Rithvik-Vadlamani/kvm-switch/verification-A2/additional-review/methods/README.md

These are the actual verification methods. Paths refer to the recorded workspace layout and must be adjusted for independent reproduction. Use the matching A2 routing geometry, netlists, firmware and Gerbers supplied in the release folders. KiCad 10 Python/CLI, C compiler, Python numpy/scipy/shapely, Gerbonara and Node sharp are required as applicable. The firmware oracle compiles actual control.c. AUDIT_LABEL=A2 selects original Gerbers for raster extraction; default selects economy. The optional bridge/missing_drill modes inject deliberate faults and are expected to report INVESTIGATE. Historical field/thermal models remain in Economy-additional-review and have not been promoted to hardware validation.
