Rithvik-Vadlamani/kvm-switch/verification-A2/additional-review/Deferred-tests.md

No physical test is marked passed. Check rail/reset waveforms for slow rise, abrupt dropout, brownout, external reset and watchdog reset; HDMI/host partially powered conditions; 4-port capacitor inrush and full-load/short-circuit recovery; USB hot-plug and both USB-C orientations; two actual monitors at 1440p60 + 1080p60; DDC/HPD/EDID; thermal rise at stepped loads and intended ambient/enclosure; exposed-pad solder joints, HDMI shield-tail proximity to R30/U20, and connector strength. Factory DFM/stackup acceptance, delivered pricing and complete channel/EMI/ESD compliance remain unverified. Start physical characterization with a current-limited supply and measure before claiming full-load operation.
