Rithvik-Vadlamani/kvm-switch/verification-A2/additional-review/Factory-status.md

No JLCDFM result or human factory approval has been obtained for A2. A separate sign-in was requested in the earlier review; the final browser check returned no active review page/report. Matching final Gerbers are supplied for submission when a signed-in session is available. No supplier message, order or payment was sent. Existing quote/cart state has not been reconciled with the new A2 parts.
