Rithvik-Vadlamani/kvm-switch/(list of files, drawings)

Other design files:
verification-A2/PCB-DRC.json
