Rithvik-Vadlamani/kvm-switch/KVM_Switch.kicad_pcb

## KiCad design KVM_Switch.kicad_pcb (2026-10-14)

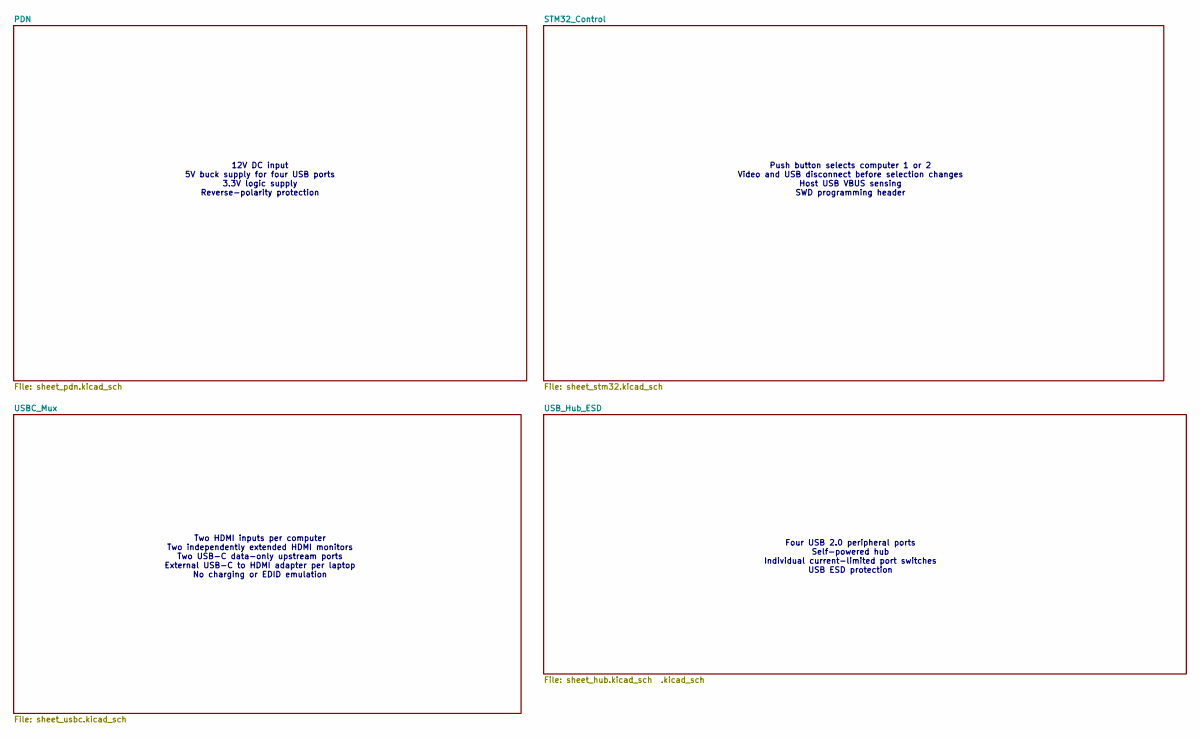
[picture p1: schematic KVM_Switch.kicad_sch, Two-computer HDMI and USB switch]

Notes on the sheet:
Four USB 2.0 peripheral ports Self-powered hub Individual current-limited port switches USB ESD protection
Two HDMI inputs per computer Two independently extended HDMI monitors Two USB-C data-only upstream ports External USB-C to HDMI adapter per laptop No charging or EDID emulation
Push button selects computer 1 or 2 Video and USB disconnect before selection changes Host USB VBUS sensing SWD programming header
12V DC input 5V buck supply for four USB ports 3.3V logic supply Reverse-polarity protection

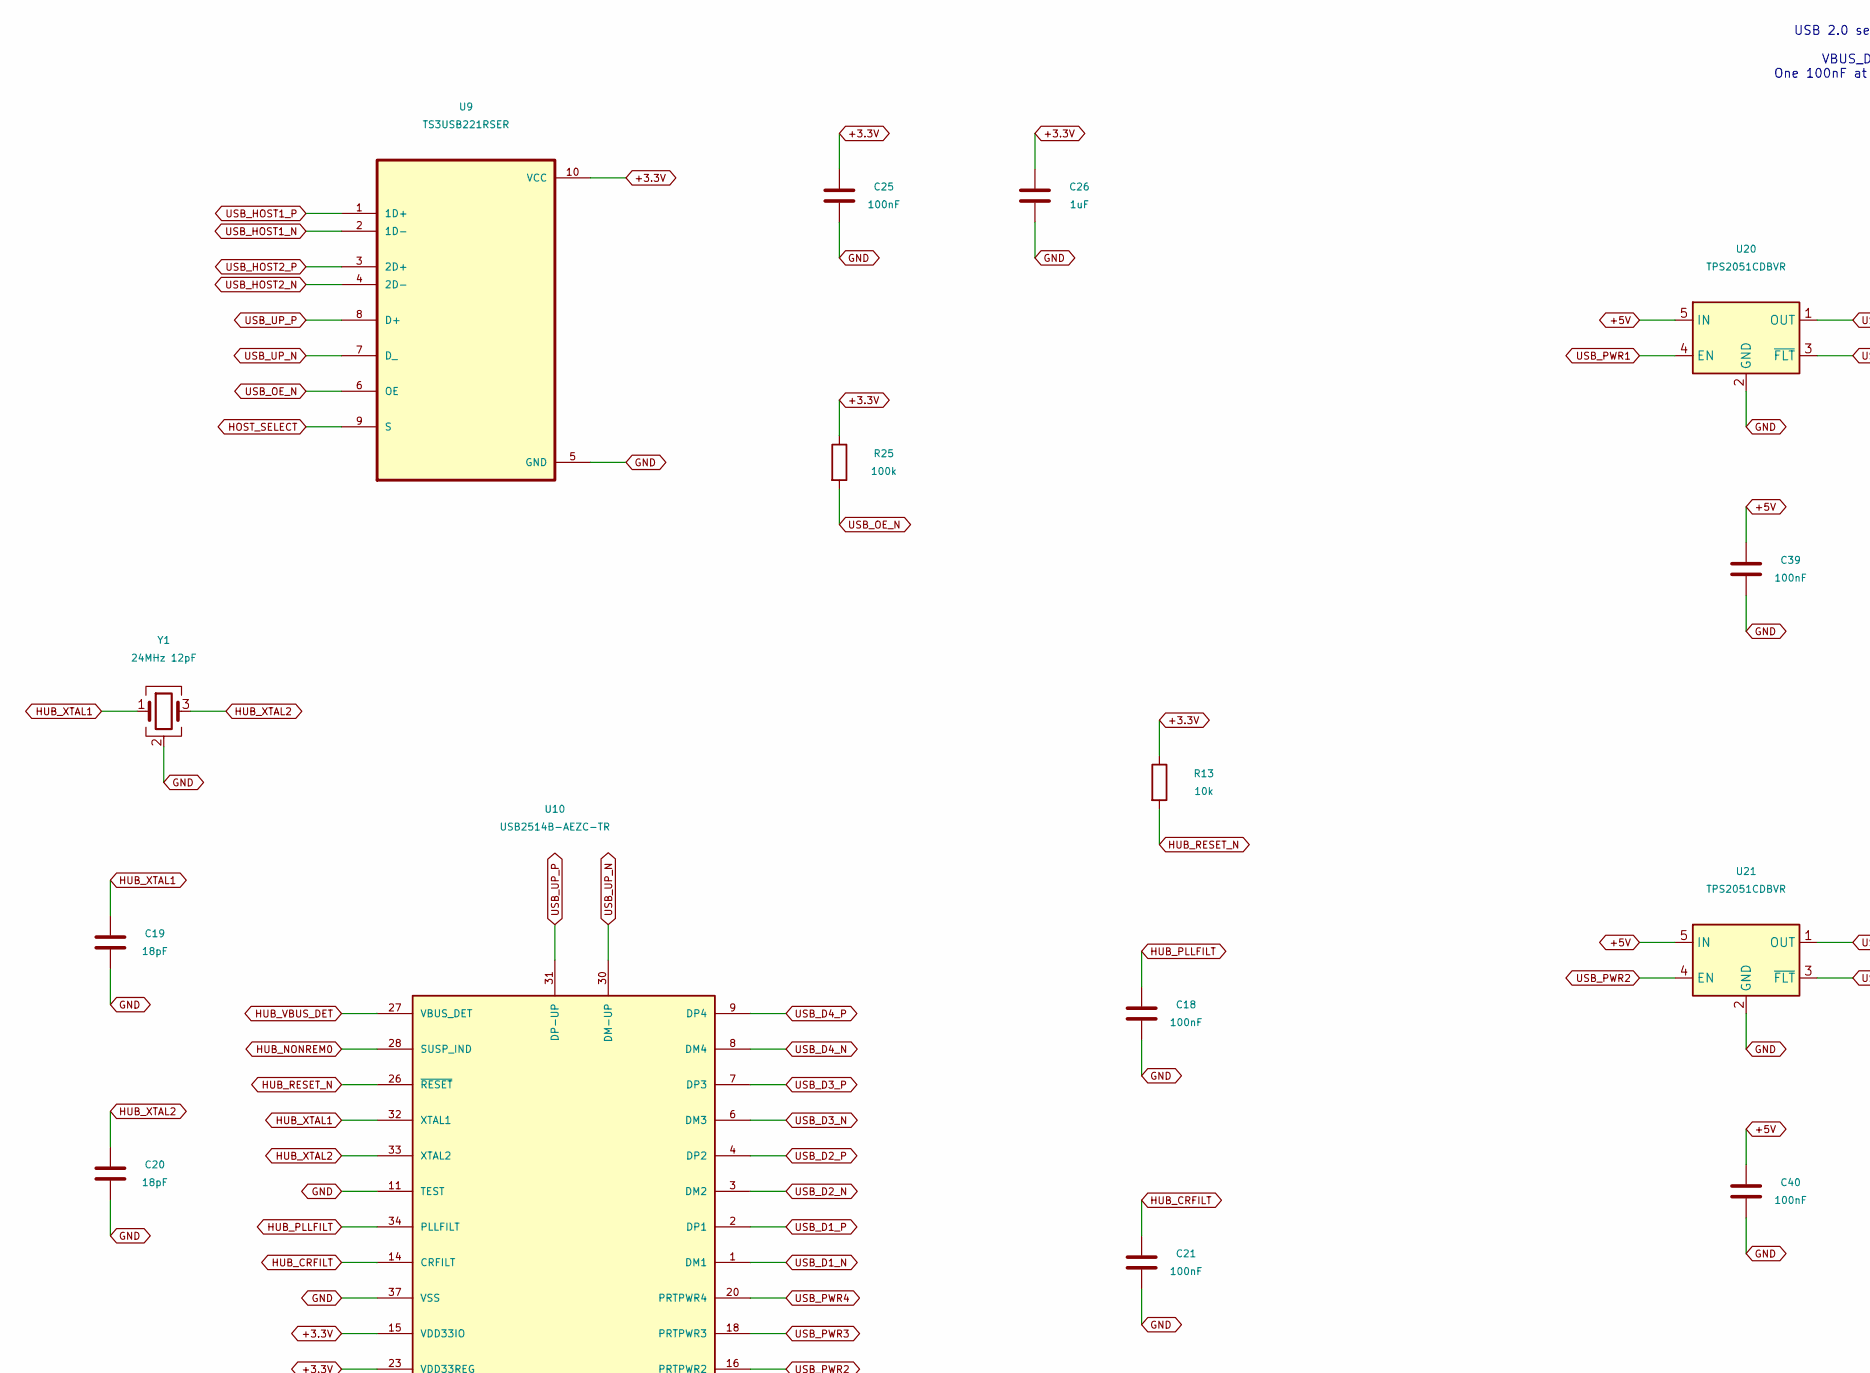
[picture p2: schematic sheet_hub.kicad_sch .kicad_sch, Two-computer HDMI and USB switch, part in row 1, column 1]

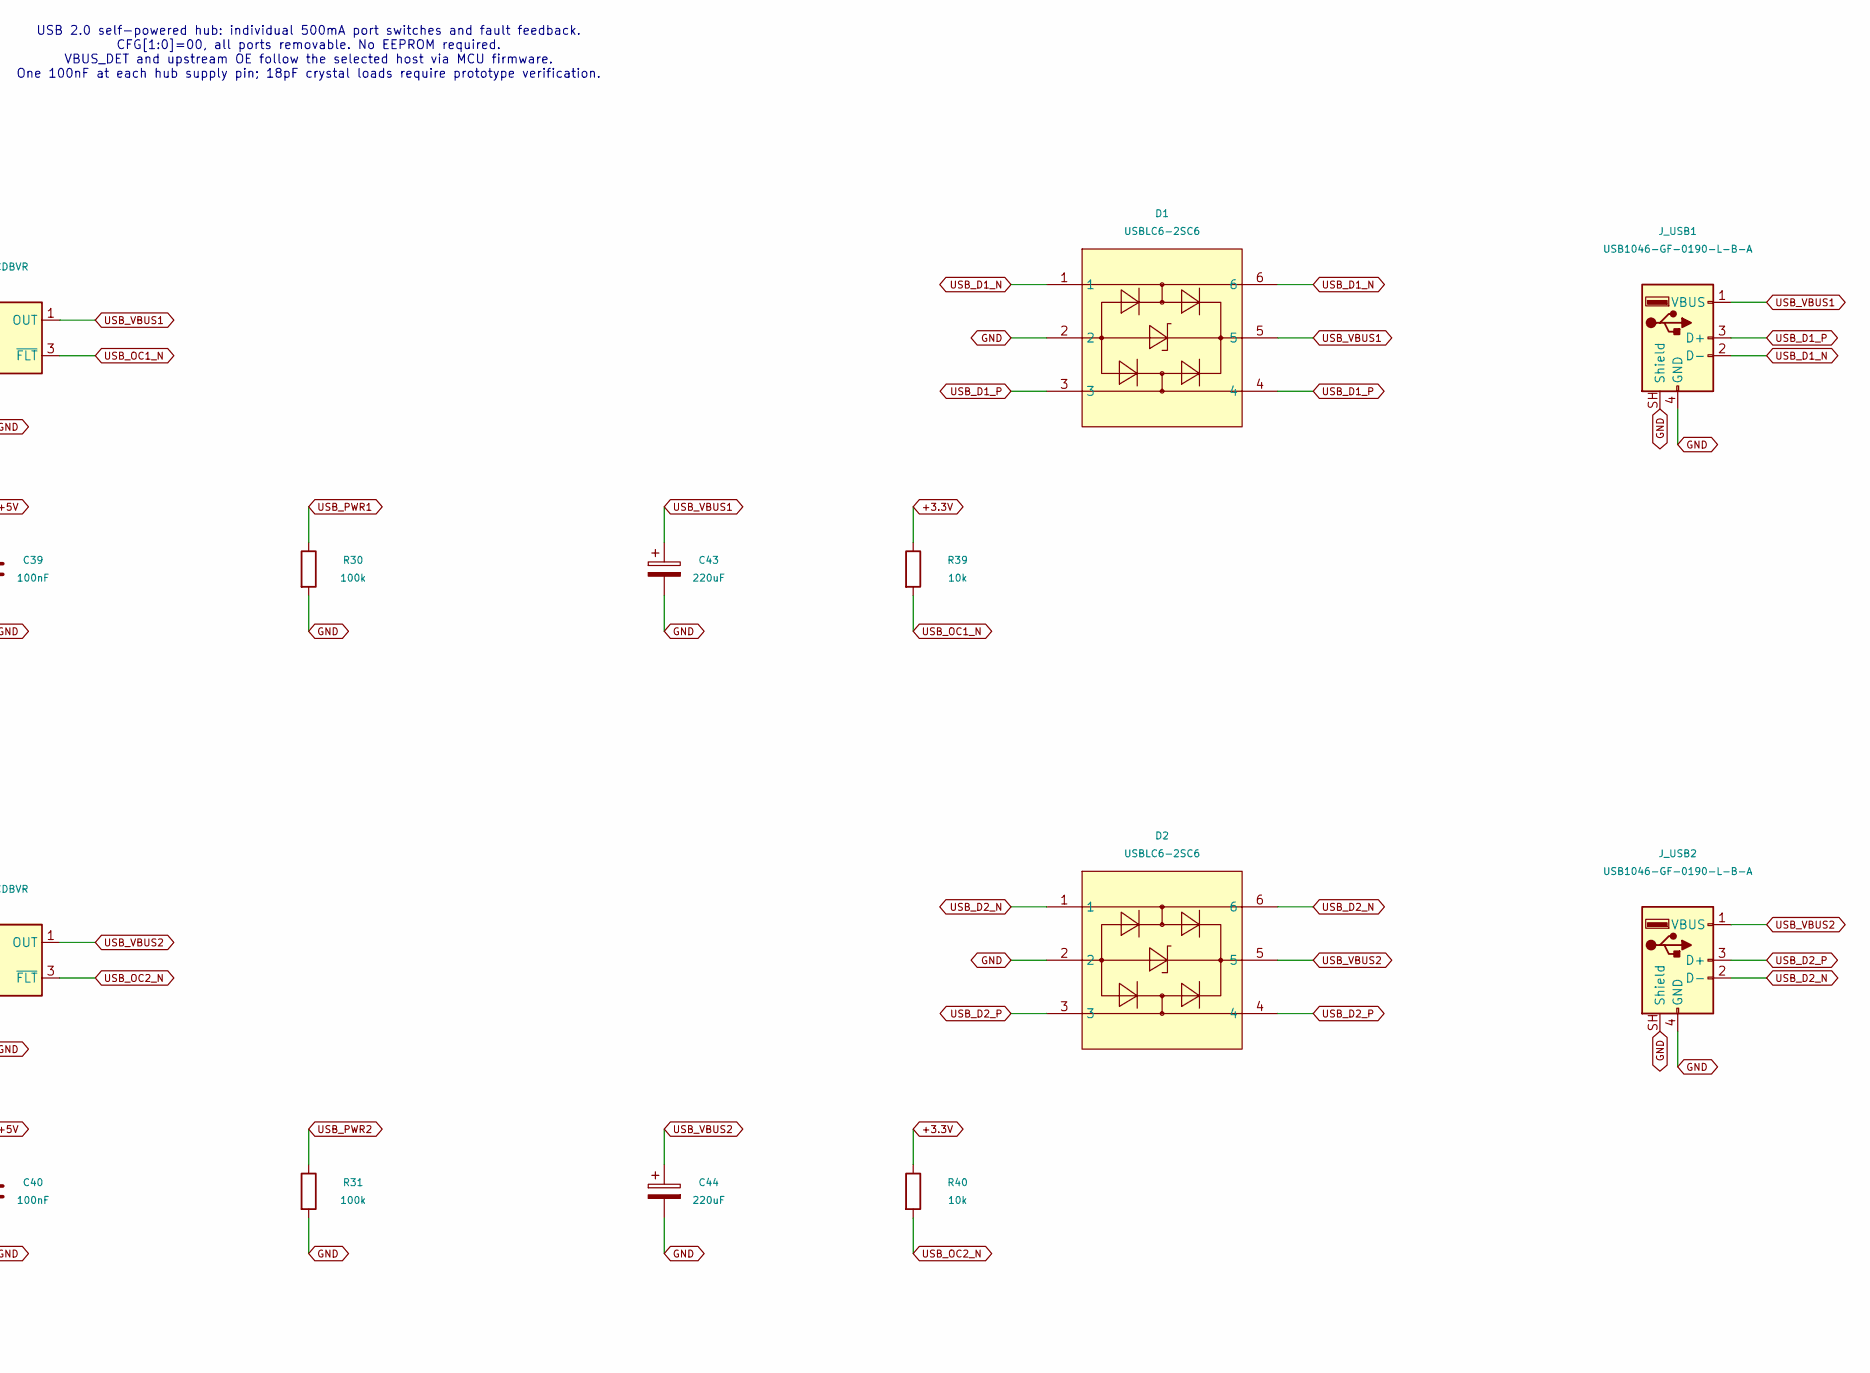
[picture p3: schematic sheet_hub.kicad_sch .kicad_sch, Two-computer HDMI and USB switch, part in row 1, column 2]

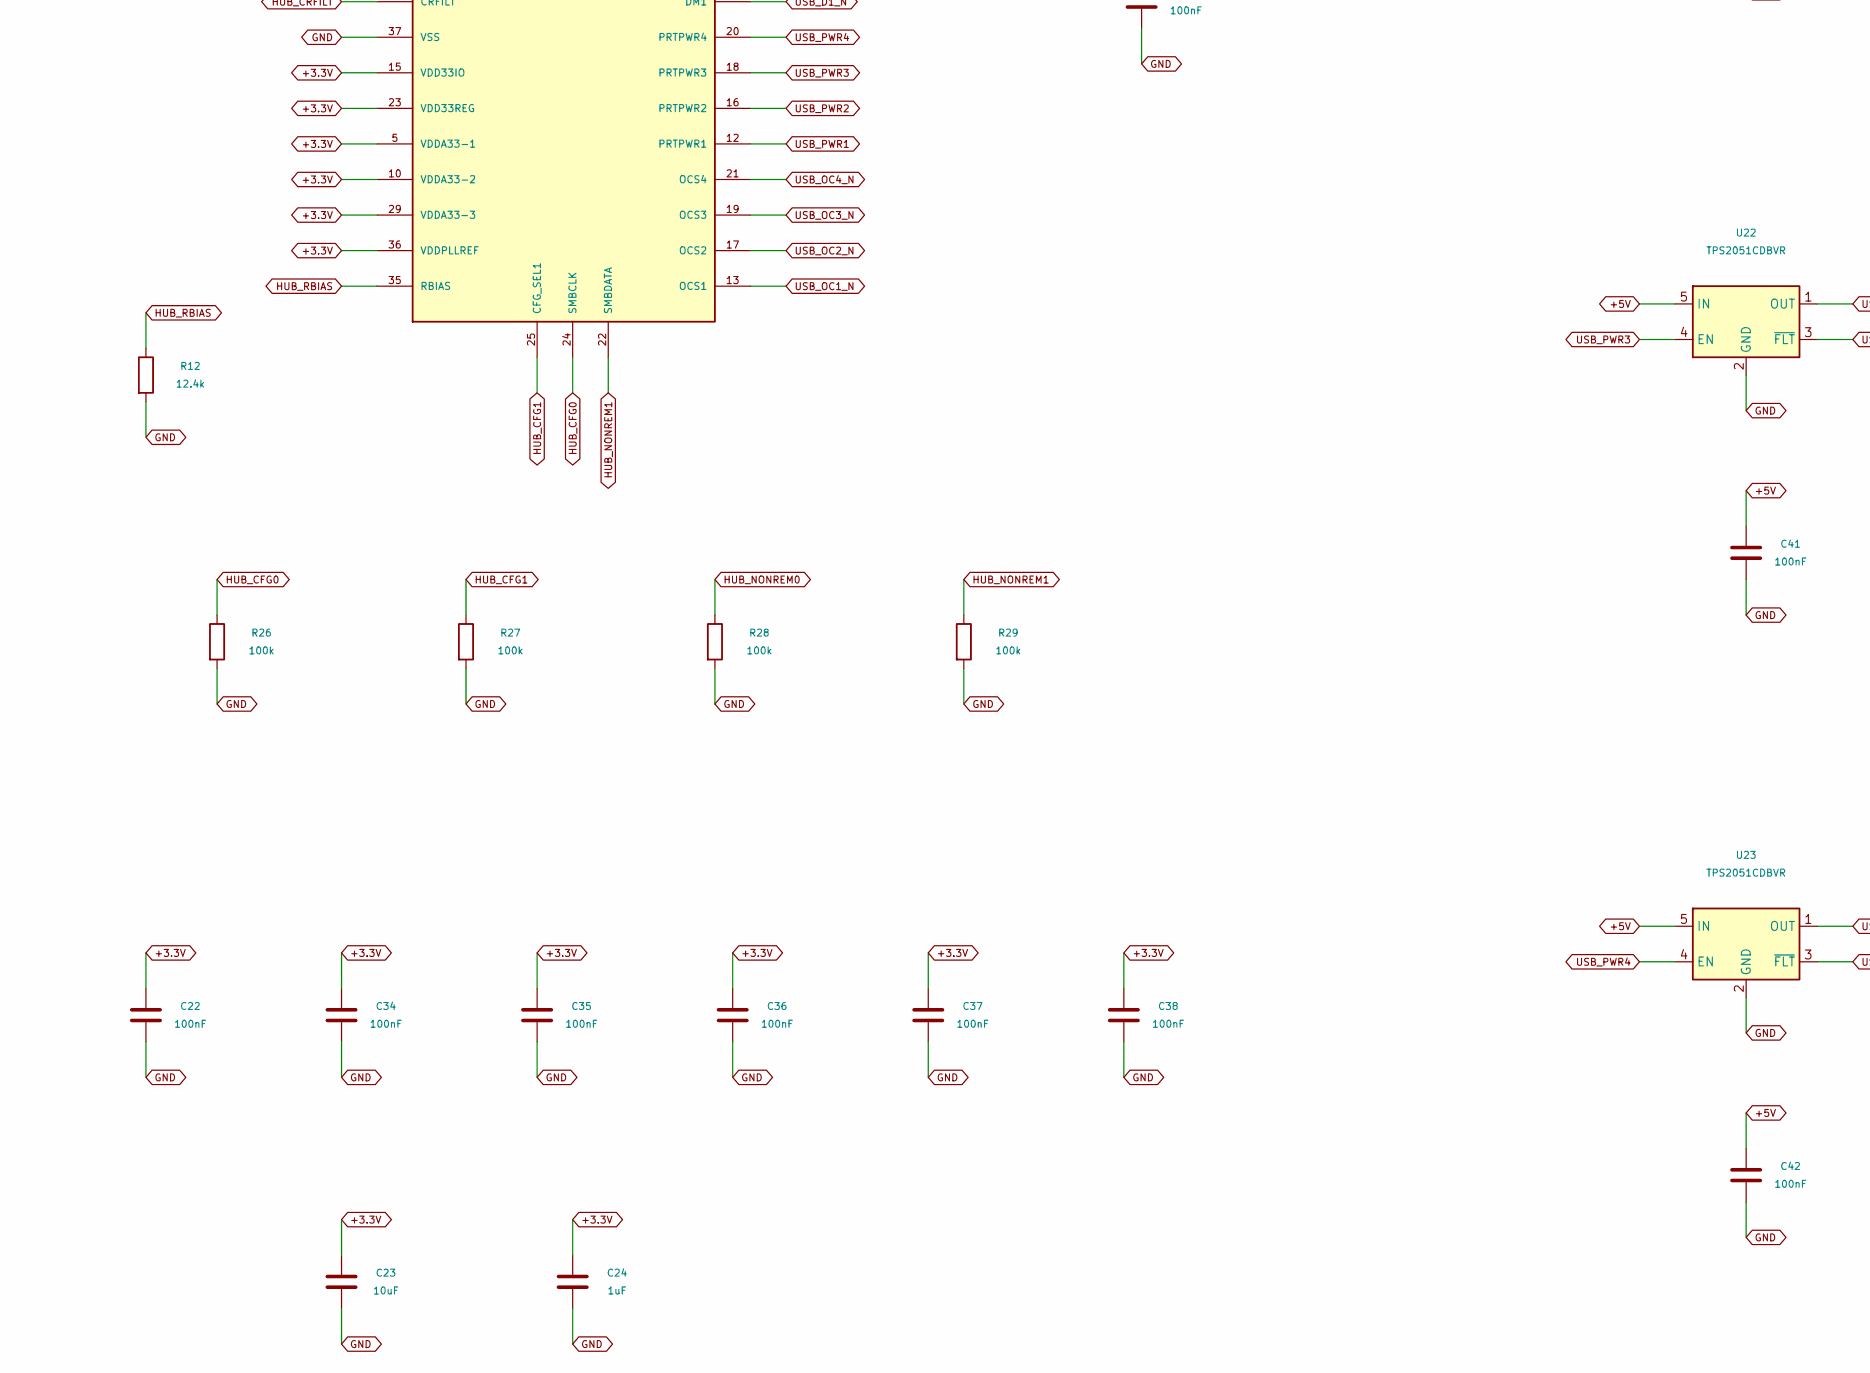
[picture p4: schematic sheet_hub.kicad_sch .kicad_sch, Two-computer HDMI and USB switch, part in row 2, column 1]

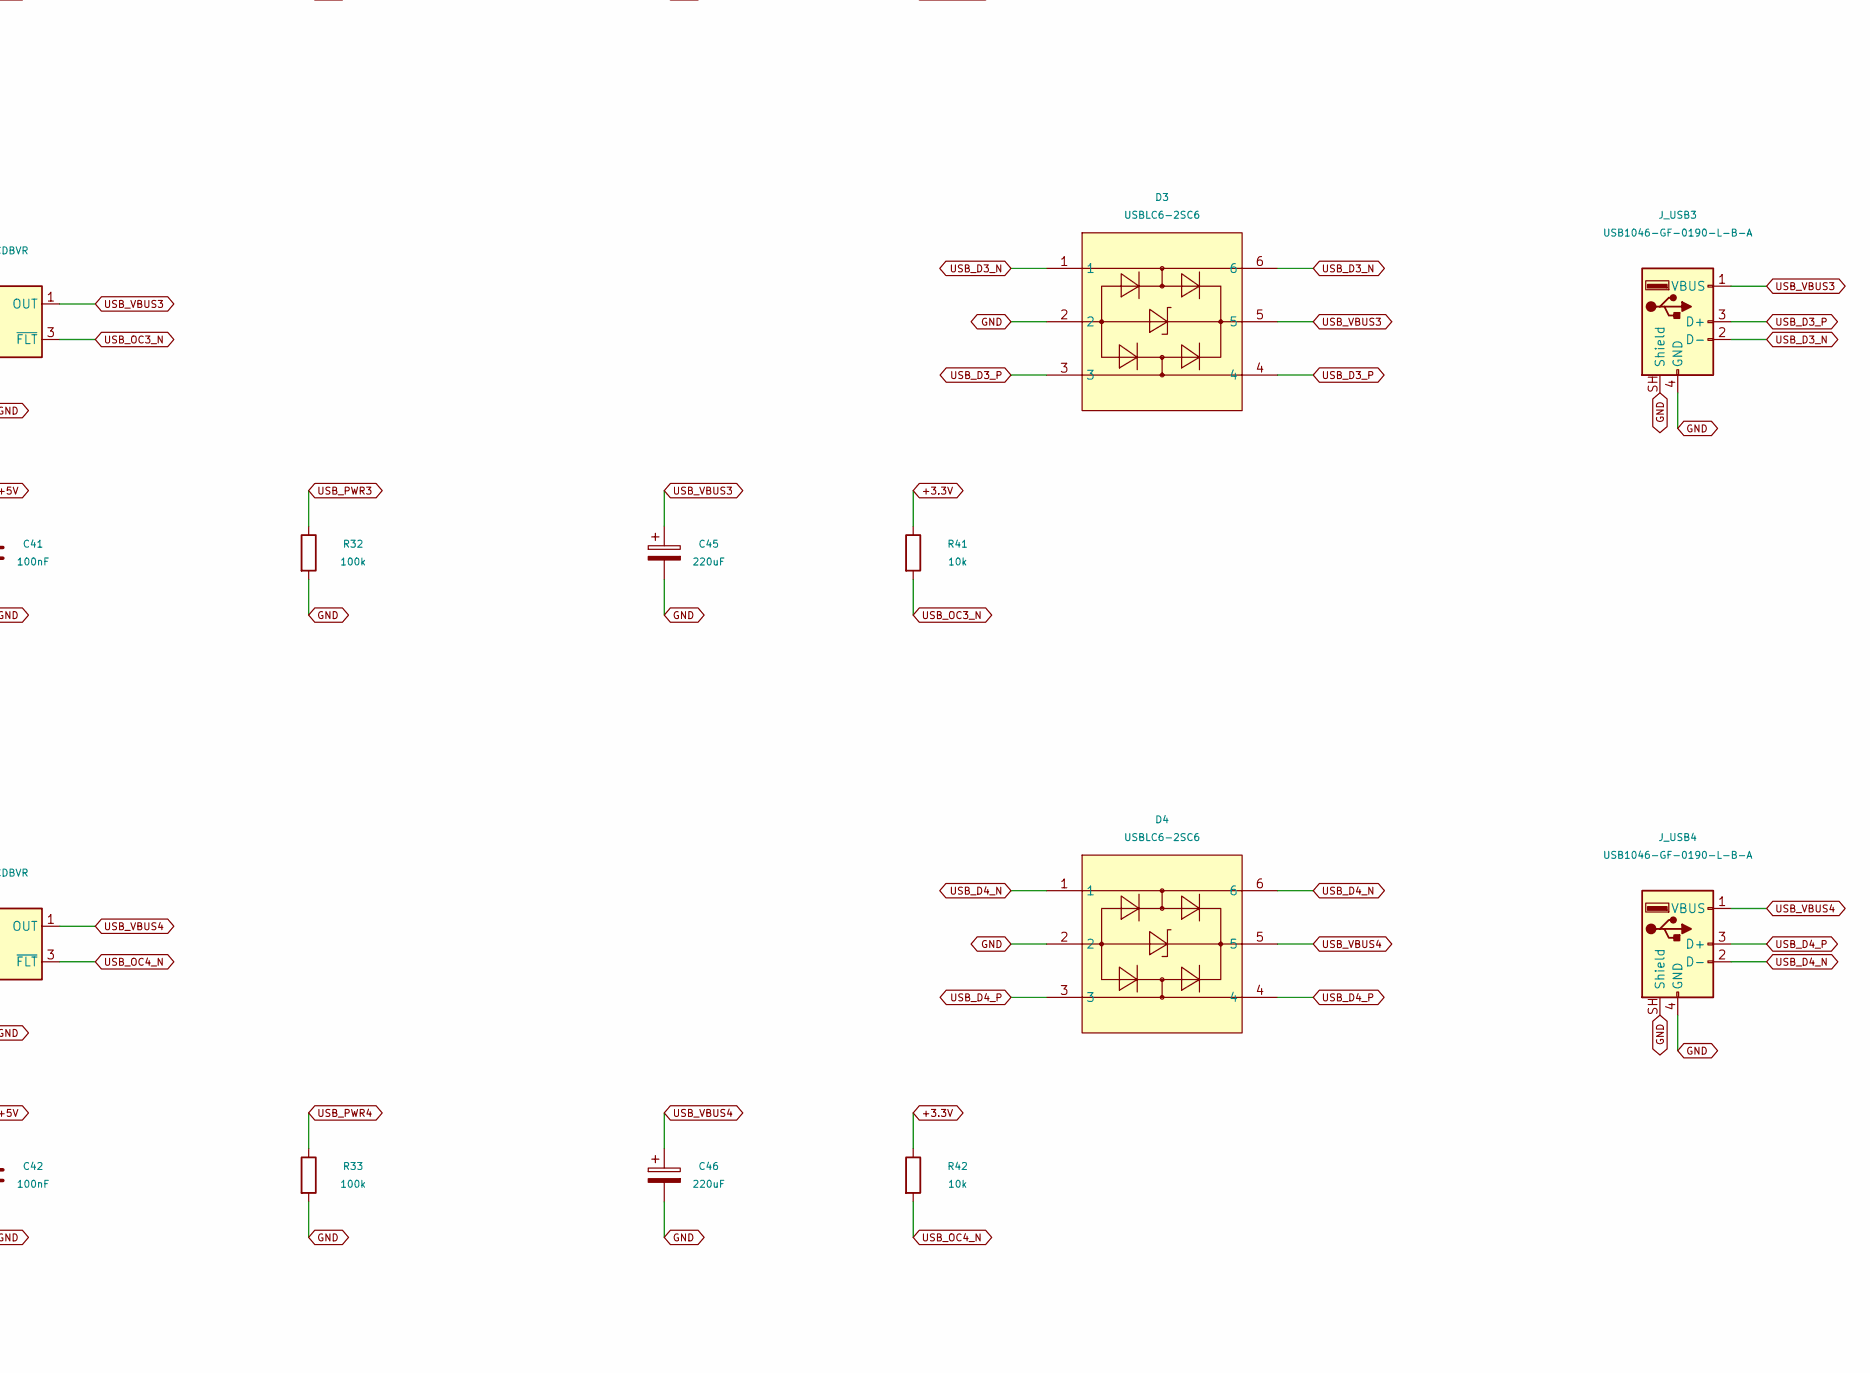
[picture p5: schematic sheet_hub.kicad_sch .kicad_sch, Two-computer HDMI and USB switch, part in row 2, column 2]

Parts:
C18: 100nF; C_0603_1608Metric; Voltage 50V; MPN CC0603KRX7R9BB104; LCSC Part C14663
C19, C20: 18pF; C_0402_1005Metric; Voltage 50V; MPN CGA2B2C0G1H180JT0Y0F; LCSC Part C76701
C21, C22, C25, C34, C35, C36, C37, C38, C39, C40, C41, C42: 100nF; C_0402_1005Metric; Voltage 50V; MPN CC0402KRX7R9BB104; LCSC Part C131394
C23: 10uF; C_0805_2012Metric; Voltage 16V; MPN CL21B106KOQNNNE; LCSC Part C95841
C24, C26: 1uF; C_0603_1608Metric; Voltage 16V; MPN CL10B105KO8NNNC; LCSC Part C59782
C43, C44, C45, C46: 220uF; CP_Elec_6.3x7.7; Voltage 10V; MPN UUD1A221MCL1GS; LCSC Part C445275
D1, D2, D3, D4: USBLC6-2SC6; SOT-23-6_L2.9-W1.6-P0.95-LS2.8-BL; MPN USBLC6-2SC6; LCSC Part C7519
J_USB1: USB1046-GF-0190-L-B-A; Assembly_J_USB1; MPN USB1046-GF-0190-L-B-A; LCSC Part C6307429
J_USB2: USB1046-GF-0190-L-B-A; Assembly_J_USB2; MPN USB1046-GF-0190-L-B-A; LCSC Part C6307429
J_USB3: USB1046-GF-0190-L-B-A; Assembly_J_USB3; MPN USB1046-GF-0190-L-B-A; LCSC Part C6307429
J_USB4: USB1046-GF-0190-L-B-A; Assembly_J_USB4; MPN USB1046-GF-0190-L-B-A; LCSC Part C6307429
R12: 12.4k; R_0402_1005Metric; Tolerance 1%; MPN 0402WGF1242TCE; LCSC Part C11692
R13, R39, R40, R41, R42: 10k; R_0402_1005Metric; Tolerance 1%; MPN 0402WGF1002TCE; LCSC Part C25744
R25, R26, R27, R28, R29, R30, R31, R32, R33: 100k; R_0402_1005Metric; Tolerance 1%; MPN 0402WGF1003TCE; LCSC Part C25741
U9: TS3USB221RSER; Texas_UQFN-10_1.5x2mm_P0.5mm; MPN TS3USB221RSER; LCSC Part C130085
U10: USB2514B-AEZC-TR; QFN-36-1EP_6x6mm_P0.5mm_EP3.7x3.7mm_ThermalVias; MPN USB2514B-AEZC-TR; LCSC Part C16251
U20, U21, U22, U23: TPS2051CDBVR; SOT-23-5; MPN TPS2051CDBVR; LCSC Part C129581
Y1: 24MHz 12pF; Assembly_Y1; MPN 3225 24M 12PF 10PPM; LCSC Part C5181479

Connections:
+3.3V: C22.1, C23.1, C24.1, C25.1, C26.1, C34.1, C35.1, C36.1, C37.1, C38.1, R13.1, R25.1, R39.1, R40.1, R41.1, R42.1, U9.10 (VCC), U10.5 (VDDA33-1), U10.10 (VDDA33-2), U10.15 (VDD33IO), U10.23 (VDD33REG), U10.29 (VDDA33-3), U10.36 (VDDPLLREF); also elsewhere on the board
+5V: C39.1, C40.1, C41.1, C42.1, U20.5 (IN), U21.5 (IN), U22.5 (IN), U23.5 (IN); also elsewhere on the board
GND: C18.2, C19.2, C20.2, C21.2, C22.2, C23.2, C24.2, C25.2, C26.2, C34.2, C35.2, C36.2, C37.2, C38.2, C39.2, C40.2, C41.2, C42.2, C43.2, C44.2, C45.2, C46.2, D1.2, D2.2, D3.2, D4.2, J_USB1.4 (GND), J_USB1.SH (Shield), J_USB2.4 (GND), J_USB2.SH (Shield), J_USB3.4 (GND), J_USB3.SH (Shield), J_USB4.4 (GND), J_USB4.SH (Shield), R12.2, R26.2, R27.2, R28.2, R29.2, R30.2, R31.2, R32.2, R33.2, U9.5 (GND), U10.11 (TEST), U10.37 (VSS), U20.2 (GND), U21.2 (GND), U22.2 (GND), U23.2 (GND), Y1.2 (G), Y1.4 (G); also elsewhere on the board
HOST_SELECT: U9.9 (S); also elsewhere on the board
HUB_CFG0: R26.1, U10.24 (SMBCLK)
HUB_CFG1: R27.1, U10.25 (CFG_SEL1)
HUB_CRFILT: C21.1, U10.14 (CRFILT)
HUB_NONREM0: R28.1, U10.28 (SUSP_IND)
HUB_NONREM1: R29.1, U10.22 (SMBDATA)
HUB_PLLFILT: C18.1, U10.34 (PLLFILT)
HUB_RBIAS: R12.1, U10.35 (RBIAS)
HUB_RESET_N: R13.2, U10.26 (~RESET); also elsewhere on the board
HUB_VBUS_DET: U10.27 (VBUS_DET); also elsewhere on the board
HUB_XTAL1: C19.1, U10.32 (XTAL1), Y1.1
HUB_XTAL2: C20.1, U10.33 (XTAL2), Y1.3
USB_D1_N: D1.1, D1.6, J_USB1.2 (D-), U10.1 (DM1)
USB_D1_P: D1.3, D1.4, J_USB1.3 (D+), U10.2 (DP1)
USB_D2_N: D2.1, D2.6, J_USB2.2 (D-), U10.3 (DM2)
USB_D2_P: D2.3, D2.4, J_USB2.3 (D+), U10.4 (DP2)
USB_D3_N: D3.1, D3.6, J_USB3.2 (D-), U10.6 (DM3)
USB_D3_P: D3.3, D3.4, J_USB3.3 (D+), U10.7 (DP3)
USB_D4_N: D4.1, D4.6, J_USB4.2 (D-), U10.8 (DM4)
USB_D4_P: D4.3, D4.4, J_USB4.3 (D+), U10.9 (DP4)
USB_HOST1_N: U9.2 (1D-); also elsewhere on the board
USB_HOST1_P: U9.1 (1D+); also elsewhere on the board
USB_HOST2_N: U9.4 (2D-); also elsewhere on the board
USB_HOST2_P: U9.3 (2D+); also elsewhere on the board
USB_OC1_N: R39.2, U10.13 (OCS1), U20.3 (~FLT)
USB_OC2_N: R40.2, U10.17 (OCS2), U21.3 (~FLT)
USB_OC3_N: R41.2, U10.19 (OCS3), U22.3 (~FLT)
USB_OC4_N: R42.2, U10.21 (OCS4), U23.3 (~FLT)
USB_OE_N: R25.2, U9.6 (OE); also elsewhere on the board
USB_PWR1: R30.1, U10.12 (PRTPWR1), U20.4 (EN)
USB_PWR2: R31.1, U10.16 (PRTPWR2), U21.4 (EN)
USB_PWR3: R32.1, U10.18 (PRTPWR3), U22.4 (EN)
USB_PWR4: R33.1, U10.20 (PRTPWR4), U23.4 (EN)
USB_UP_N: U9.7 (D_), U10.30 (DM-UP)
USB_UP_P: U9.8 (D+), U10.31 (DP-UP)
USB_VBUS1: C43.1, D1.5, J_USB1.1 (VBUS), U20.1 (OUT)
USB_VBUS2: C44.1, D2.5, J_USB2.1 (VBUS), U21.1 (OUT)
USB_VBUS3: C45.1, D3.5, J_USB3.1 (VBUS), U22.1 (OUT)
USB_VBUS4: C46.1, D4.5, J_USB4.1 (VBUS), U23.1 (OUT)

Notes on the sheet:
USB 2.0 self-powered hub: individual 500mA port switches and fault feedback. CFG[1:0]=00, all ports removable. No EEPROM required. VBUS_DET and upstream OE follow the selected host via MCU firmware. One 100nF at each hub supply pin; 18pF crystal loads require prototype verification.

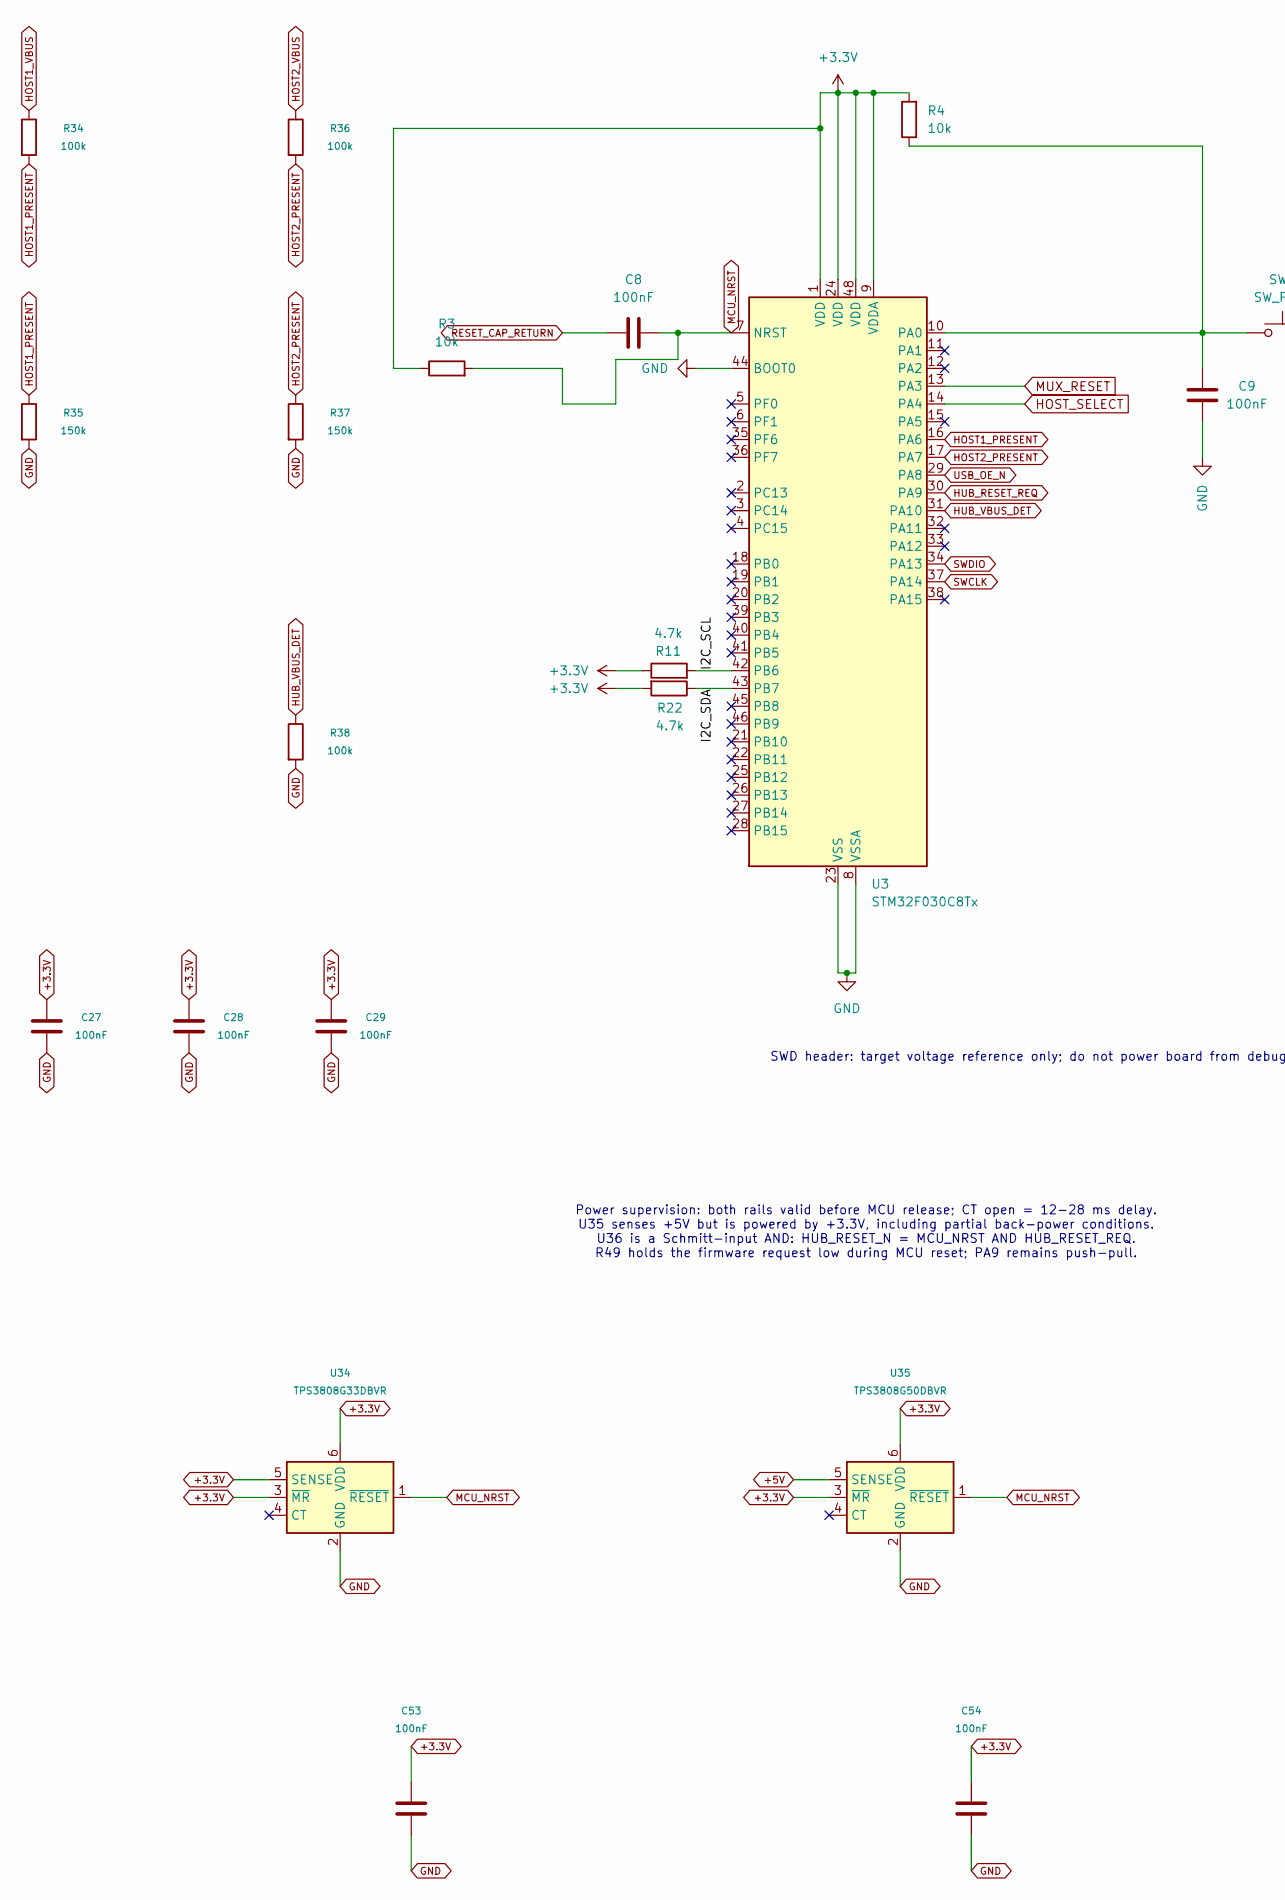
[picture p6: schematic sheet_stm32.kicad_sch, Two-computer HDMI and USB switch, part in row 1, column 1]

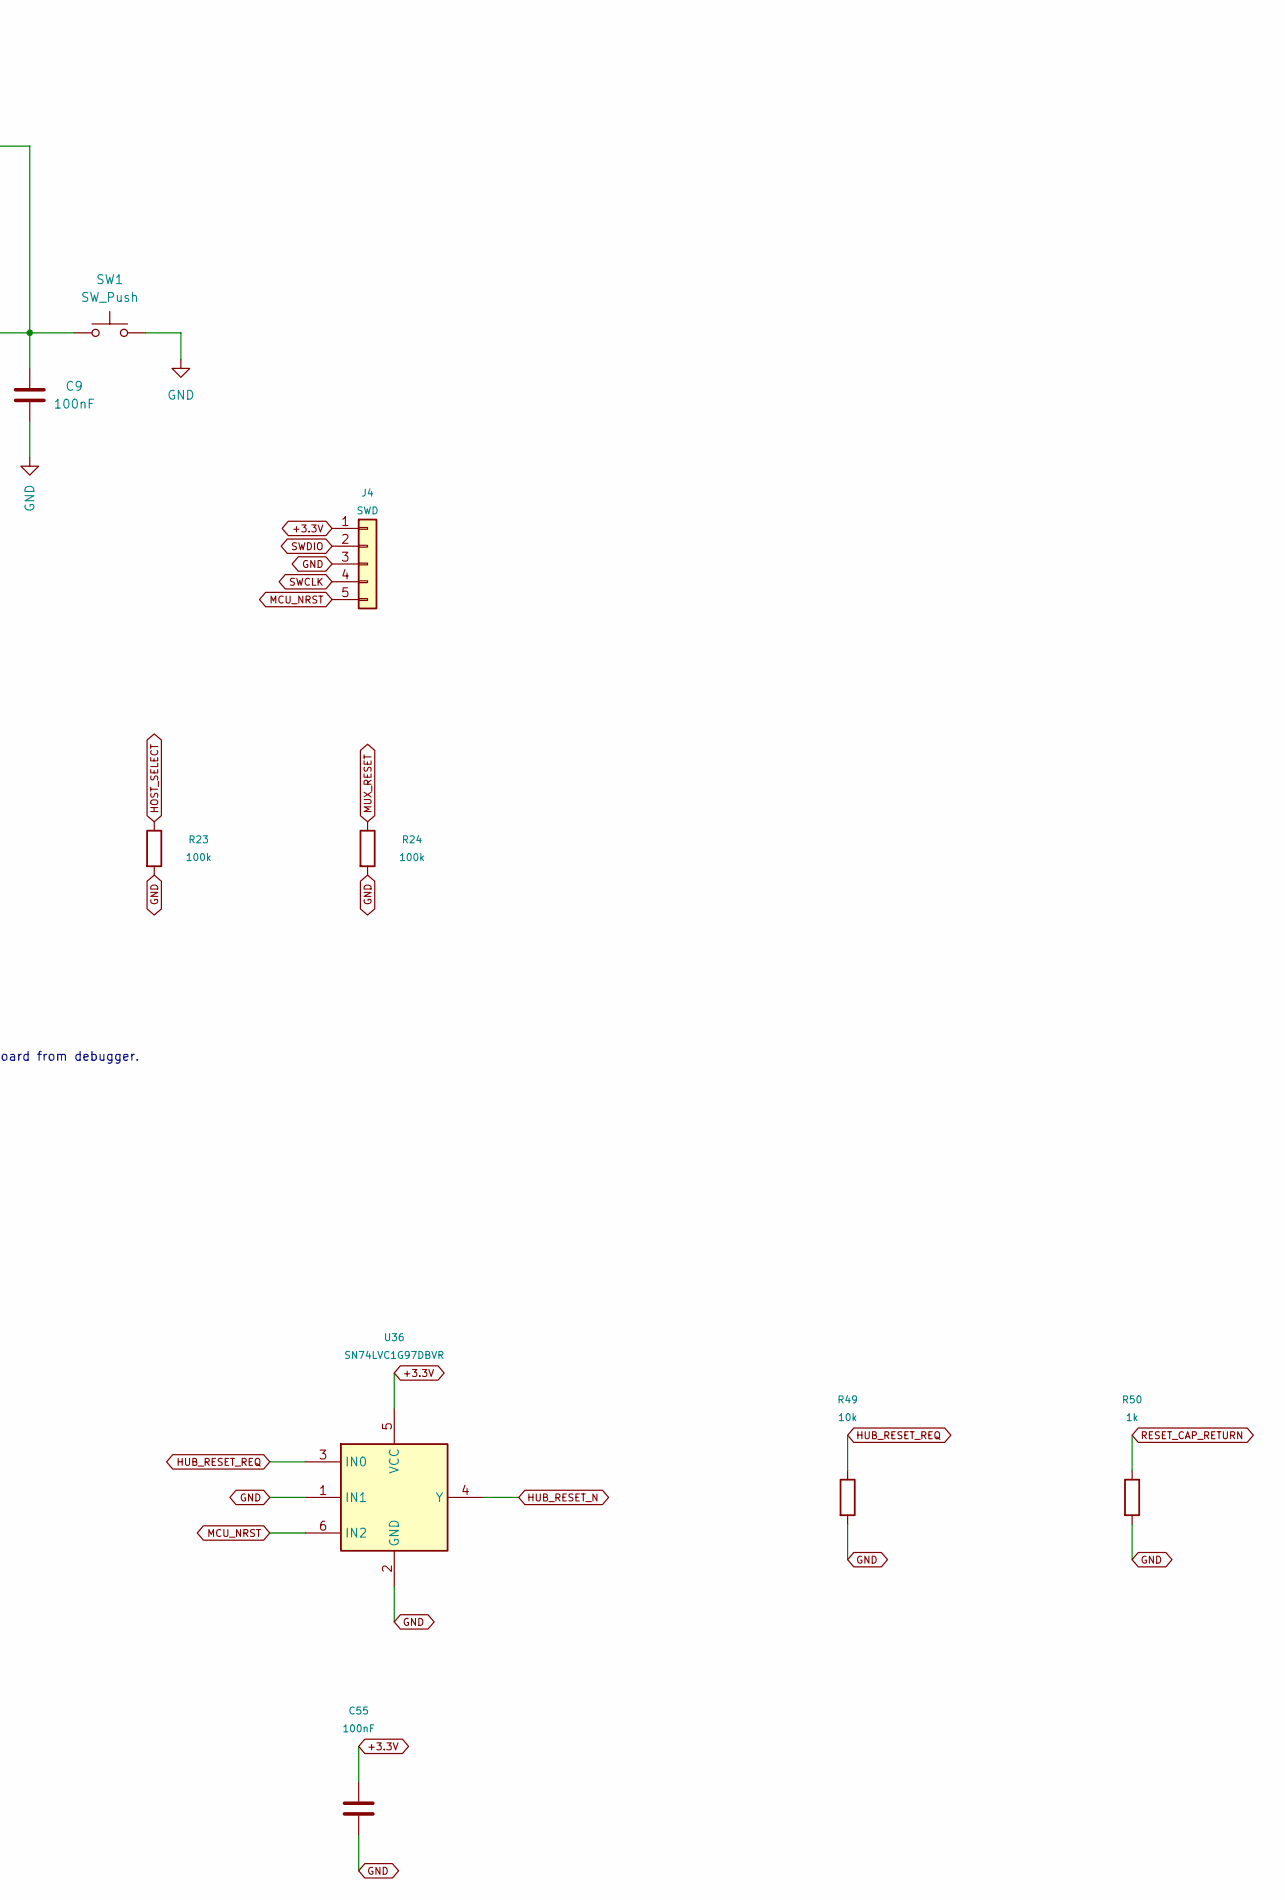
[picture p7: schematic sheet_stm32.kicad_sch, Two-computer HDMI and USB switch, part in row 1, column 2]

Parts:
C8, C9, C27, C28, C29, C53, C54, C55: 100nF; C_0402_1005Metric; Voltage 50V; MPN CC0402KRX7R9BB104; LCSC Part C131394
J4: SWD; PinHeader_1x05_P2.54mm_Vertical; MPN PZ2.54-1X5P-H25; LCSC Part C42431812
R3, R4: 10k; R_0402_1005Metric; Tolerance 1%; MPN 0402WGF1002TCE; LCSC Part C25744
R11, R22: 4.7k; R_0402_1005Metric; Tolerance 1%; MPN 0402WGF4701TCE; LCSC Part C25900
R23, R24, R34, R36, R38: 100k; R_0402_1005Metric; Tolerance 1%; MPN 0402WGF1003TCE; LCSC Part C25741
R35, R37: 150k; R_0402_1005Metric; Tolerance 1%; MPN 0402WGF1503TCE; LCSC Part C25755
R49: 10k; R_0402_1005Metric; MPN 0402WGF1002TCE; LCSC Part C25744
R50: 1k; R_0402_1005Metric; MPN 0402WGF1001TCE; LCSC Part C11702
SW1: SW_Push; SW_SPST_Omron_B3F-40xx; MPN B3F-4050; LCSC Part C86707
U3: STM32F030C8Tx; LQFP-48_7x7mm_P0.5mm; MPN STM32F030C8T6; LCSC Part C23922
U34: TPS3808G33DBVR; SOT-23-6; MPN TPS3808G33DBVR; LCSC Part C43698
U35: TPS3808G50DBVR; SOT-23-6; MPN TPS3808G50DBVR; LCSC Part C134123
U36: SN74LVC1G97DBVR; SOT-23-6; MPN SN74LVC1G97DBVR; LCSC Part C128411

Connections:
+3.3V: C27.1, C28.1, C29.1, C53.1, C54.1, C55.1, J4.1, R3.1, R4.2, R11.1, R22.2, U3.1 (VDD), U3.9 (VDDA), U3.24 (VDD), U3.48 (VDD), U34.3 (~MR), U34.5 (SENSE), U34.6 (VDD), U35.3 (~MR), U35.6 (VDD), U36.5 (VCC); also elsewhere on the board
+5V: U35.5 (SENSE); also elsewhere on the board
/STM32_Control/I2C_SCL: R11.2, U3.42 (PB6)
/STM32_Control/I2C_SDA: R22.1, U3.43 (PB7)
GND: C9.2, C27.2, C28.2, C29.2, C53.2, C54.2, C55.2, J4.3, R23.2, R24.2, R35.2, R37.2, R38.2, R49.2, R50.2, SW1.2, U3.8 (VSSA), U3.23 (VSS), U3.44 (BOOT0), U3.47 (VSS), U34.2 (GND), U35.2 (GND), U36.1 (IN1), U36.2 (GND); also elsewhere on the board
HOST1_PRESENT: R34.2, R35.1, U3.16 (PA6)
HOST1_VBUS: R34.1; also elsewhere on the board
HOST2_PRESENT: R36.2, R37.1, U3.17 (PA7)
HOST2_VBUS: R36.1; also elsewhere on the board
HOST_SELECT: R23.1, U3.14 (PA4); also elsewhere on the board
HUB_RESET_N: U36.4 (Y); also elsewhere on the board
HUB_RESET_REQ: R49.1, U3.30 (PA9), U36.3 (IN0)
HUB_VBUS_DET: R38.1, U3.31 (PA10); also elsewhere on the board
MCU_NRST: C8.2, J4.5, R3.2, U3.7 (NRST), U34.1 (~RESET), U35.1 (~RESET), U36.6 (IN2)
MUX_RESET: R24.1, U3.13 (PA3); also elsewhere on the board
unnamed: C9.1, R4.1, SW1.1, U3.10 (PA0)
RESET_CAP_RETURN: C8.1, R50.1
SWCLK: J4.4, U3.37 (PA14)
SWDIO: J4.2, U3.34 (PA13)
USB_OE_N: U3.29 (PA8); also elsewhere on the board

Notes on the sheet:
SWD header: target voltage reference only; do not power board from debugger.
Power supervision: both rails valid before MCU release; CT open = 12-28 ms delay. U35 senses +5V but is powered by +3.3V, including partial back-power conditions. U36 is a Schmitt-input AND: HUB_RESET_N = MCU_NRST AND HUB_RESET_REQ. R49 holds the firmware request low during MCU reset; PA9 remains p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
