Rithvik-Vadlamani/kvm-switch/KVM_Switch.kicad_pcb

## KiCad design KVM_Switch.kicad_pcb (continued)

Schematic: sheet_usbc.kicad_sch, Two-computer HDMI and USB switch

Parts:
C10, C11, C12, C13, C14, C15: 0.1uF; C_0402_1005Metric; Voltage 50V; MPN CC0402KRX7R9BB104; LCSC Part C131394
C47, C48: 100nF; C_0402_1005Metric; Voltage 50V; MPN CC0402KRX7R9BB104; LCSC Part C131394
C49, C50: 1uF; C_0603_1608Metric; Voltage 16V; MPN CL10B105KO8NNNC; LCSC Part C59782
J1, J2: USB4105-GF-A-120; USB_C_Receptacle_GCT_USB4105-xx-A_16P_TopMnt_Horizontal; MPN USB4105-GF-A-120; LCSC Part C5184243
J_HDMI_C1_MON1: HDMI_A_1.4; Assembly_J_HDMI_C1_MON1; MPN 2086581001; LCSC Part C916313
J_HDMI_C1_MON2: HDMI_A_1.4; Assembly_J_HDMI_C1_MON2; MPN 2086581001; LCSC Part C916313
J_HDMI_C2_MON1: HDMI_A_1.4; Assembly_J_HDMI_C2_MON1; MPN 2086581001; LCSC Part C916313
J_HDMI_C2_MON2: HDMI_A_1.4; Assembly_J_HDMI_C2_MON2; MPN 2086581001; LCSC Part C916313
J_HDMI_MON1: HDMI_A_1.4; Assembly_J_HDMI_MON1; MPN 2086581001; LCSC Part C916313
J_HDMI_MON2: HDMI_A_1.4; Assembly_J_HDMI_MON2; MPN 2086581001; LCSC Part C916313
R6, R14, R15, R16: 47k; R_0402_1005Metric; Tolerance 1%; MPN 0402WGF4702TCE; LCSC Part C25792
R7, R8, R9, R10: 5.1k; R_0402_1005Metric; Tolerance 1%; MPN 0402WGF5101TCE; LCSC Part C25905
R17, R18, R19, R20: 100k; R_0402_1005Metric; Tolerance 1%; MPN 0402WGF1003TCE; LCSC Part C25741
R43, R45: 10k; R_0402_1005Metric; Tolerance 1%; MPN 0402WGF1002TCE; LCSC Part C25744
R44: 10k; Assembly_R44; Tolerance 1%; MPN 0402WGF1002TCE; LCSC Part C25744
R46: 10k; Assembly_R46; Tolerance 1%; MPN 0402WGF1002TCE; LCSC Part C25744
R47, R48: 210k; R_0402_1005Metric; Tolerance 1%; MPN AF0402FR-07210KL; LCSC Part C20143942
U4, U5, U7, U11, U12, U13, U14, U15, U16, U17, U18, U19: TPD4E02B04DQA; USON-10_2.5x1.0mm_P0.5mm_Assembly; MPN TPD4E02B04DQAR; LCSC Part C106794
U6, U8: HD3SS215IRTQR; QFN-56-1EP_8x8mm_P0.5mm_EP4.5x5.2mm_ThermalVias; MPN HD3SS215IRTQT; LCSC Part C2674402
U24, U25, U26, U27, U28, U29, U30, U31: TPD4E05U06DQAR; USON-10_2.5x1.0mm_P0.5mm_Assembly; MPN TPD4E05U06DQAR; LCSC Part C138714
U32, U33: TPS2553DBVR; SOT-23-6; MPN TPS2553DBVR; LCSC Part C55266

Connections:
+3.3V: C10.1, C11.1, C12.1, C13.1, C14.1, C15.1, R43.1, R45.1, U6.19 (VDD), U6.55 (VDD), U8.19 (VDD), U8.55 (VDD), U32.3 (EN), U33.3 (EN); also elsewhere on the board
+5V: C47.1, C48.1, U32.1 (IN), U33.1 (IN); also elsewhere on the board
/USBC_Mux/C1_MON1_D0_N: J_HDMI_C1_MON1.9 (D0-), U6.47 (DA2(n)), U13.2 (IO2), U13.9 (NC)
/USBC_Mux/C1_MON1_D0_P: J_HDMI_C1_MON1.7 (D0+), U6.48 (DA2(p)), U13.1 (IO1), U13.10 (NC)
/USBC_Mux/C1_MON1_D1_N: J_HDMI_C1_MON1.6 (D1-), U6.50 (DA1(n)), U12.5 (IO4), U12.6 (NC)
/USBC_Mux/C1_MON1_D1_P: J_HDMI_C1_MON1.4 (D1+), U6.51 (DA1(p)), U12.4 (IO3), U12.7 (NC)
/USBC_Mux/C1_MON1_D2_N: J_HDMI_C1_MON1.3 (D2-), U6.53 (DA0(n)), U12.2 (IO2), U12.9 (NC)
/USBC_Mux/C1_MON1_D2_P: J_HDMI_C1_MON1.1 (D2+), U6.54 (DA0(p)), U12.1 (IO1), U12.10 (NC)
/USBC_Mux/C1_MON1_D3_N: J_HDMI_C1_MON1.12 (CK-), U6.44 (DA3(n)), U13.5 (IO4), U13.6 (NC)
/USBC_Mux/C1_MON1_D3_P: J_HDMI_C1_MON1.10 (CK+), U6.45 (DA3(p)), U13.4 (IO3), U13.7 (NC)
/USBC_Mux/C1_MON1_DDC_CLK: J_HDMI_C1_MON1.15 (SCL), U6.27 (DDCCLK_A), U26.1 (IO1)
/USBC_Mux/C1_MON1_DDC_DAT: J_HDMI_C1_MON1.16 (SDA), U6.28 (DDCDAT_A), U26.2 (IO2)
/USBC_Mux/C1_MON1_HPD: J_HDMI_C1_MON1.19 (HPD/HEAC-), R17.1, U6.16 (HPDA), U26.4 (IO3)
/USBC_Mux/C1_MON2_D0_N: J_HDMI_C1_MON2.9 (D0-), U8.51 (DA1(p)), U17.2 (IO2), U17.9 (NC)
/USBC_Mux/C1_MON2_D0_P: J_HDMI_C1_MON2.7 (D0+), U8.50 (DA1(n)), U17.1 (IO1), U17.10 (NC)
/USBC_Mux/C1_MON2_D1_N: J_HDMI_C1_MON2.6 (D1-), U8.48 (DA2(p)), U16.5 (IO4), U16.6 (NC)
/USBC_Mux/C1_MON2_D1_P: J_HDMI_C1_MON2.4 (D1+), U8.47 (DA2(n)), U16.4 (IO3), U16.7 (NC)
/USBC_Mux/C1_MON2_D2_N: J_HDMI_C1_MON2.3 (D2-), U8.45 (DA3(p)), U16.2 (IO2), U16.9 (NC)
/USBC_Mux/C1_MON2_D2_P: J_HDMI_C1_MON2.1 (D2+), U8.44 (DA3(n)), U16.1 (IO1), U16.10 (NC)
/USBC_Mux/C1_MON2_D3_N: J_HDMI_C1_MON2.12 (CK-), U8.54 (DA0(p)), U17.5 (IO4), U17.6 (NC)
/USBC_Mux/C1_MON2_D3_P: J_HDMI_C1_MON2.10 (CK+), U8.53 (DA0(n)), U17.4 (IO3), U17.7 (NC)
/USBC_Mux/C1_MON2_DDC_CLK: J_HDMI_C1_MON2.15 (SCL), U8.27 (DDCCLK_A), U28.1 (IO1)
/USBC_Mux/C1_MON2_DDC_DAT: J_HDMI_C1_MON2.16 (SDA), U8.28 (DDCDAT_A), U28.2 (IO2), U28.9 (NC)
/USBC_Mux/C1_MON2_HPD: J_HDMI_C1_MON2.19 (HPD/HEAC-), R19.1, U8.16 (HPDA), U28.4 (IO3)
/USBC_Mux/C2_MON1_D0_N: J_HDMI_C2_MON1.9 (D0-), U6.34 (DB2(n)), U15.2 (IO2), U15.9 (NC)
/USBC_Mux/C2_MON1_D0_P: J_HDMI_C2_MON1.7 (D0+), U6.35 (DB2(p)), U15.1 (IO1), U15.10 (NC)
/USBC_Mux/C2_MON1_D1_N: J_HDMI_C2_MON1.6 (D1-), U6.37 (DB1(n)), U14.5 (IO4), U14.6 (NC)
/USBC_Mux/C2_MON1_D1_P: J_HDMI_C2_MON1.4 (D1+), U6.38 (DB1(p)), U14.4 (IO3), U14.7 (NC)
/USBC_Mux/C2_MON1_D2_N: J_HDMI_C2_MON1.3 (D2-), U6.40 (DB0(n)), U14.2 (IO2), U14.9 (NC)
/USBC_Mux/C2_MON1_D2_P: J_HDMI_C2_MON1.1 (D2+), U6.41 (DB0(p)), U14.1 (IO1), U14.10 (NC)
/USBC_Mux/C2_MON1_D3_N: J_HDMI_C2_MON1.12 (CK-), U6.31 (DB3(n)), U15.5 (IO4), U15.6 (NC)
/USBC_Mux/C2_MON1_D3_P: J_HDMI_C2_MON1.10 (CK+), U6.32 (DB3(p)), U15.4 (IO3), U15.7 (NC)
/USBC_Mux/C2_MON1_DDC_CLK: J_HDMI_C2_MON1.15 (SCL), U6.22 (DDCCLK_B), U27.1 (IO1)
/USBC_Mux/C2_MON1_DDC_DAT: J_HDMI_C2_MON1.16 (SDA), U6.23 (DDCDAT_B), U27.2 (IO2)
/USBC_Mux/C2_MON1_HPD: J_HDMI_C2_MON1.19 (HPD/HEAC-), R18.1, U6.17 (HPDB), U27.4 (IO3)
/USBC_Mux/C2_MON2_D0_N: J_HDMI_C2_MON2.9 (D0-), U8.38 (DB1(p)), U19.2 (IO2), U19.9 (NC)
/USBC_Mux/C2_MON2_D0_P: J_HDMI_C2_MON2.7 (D0+), U8.37 (DB1(n)), U19.1 (IO1), U19.10 (NC)
/USBC_Mux/C2_MON2_D1_N: J_HDMI_C2_MON2.6 (D1-), U8.35 (DB2(p)), U18.5 (IO4), U18.6 (NC)
/USBC_Mux/C2_MON2_D1_P: J_HDMI_C2_MON2.4 (D1+), U8.34 (DB2(n)), U18.4 (IO3), U18.7 (NC)
/USBC_Mux/C2_MON2_D2_N: J_HDMI_C2_MON2.3 (D2-), U8.32 (DB3(p)), U18.2 (IO2), U18.9 (NC)
/USBC_Mux/C2_MON2_D2_P: J_HDMI_C2_MON2.1 (D2+), U8.31 (DB3(n)), U18.1 (IO1), U18.10 (NC)
/USBC_Mux/C2_MON2_D3_N: J_HDMI_C2_MON2.12 (CK-), U8.41 (DB0(p)), U19.5 (IO4), U19.6 (NC)
/USBC_Mux/C2_MON2_D3_P: J_HDMI_C2_MON2.10 (CK+), U8.40 (DB0(n)), U19.4 (IO3), U19.7 (NC)
/USBC_Mux/C2_MON2_DDC_CLK: J_HDMI_C2_MON2.15 (SCL), U8.22 (DDCCLK_B), U29.1 (IO1)
/USBC_Mux/C2_MON2_DDC_DAT: J_HDMI_C2_MON2.16 (SDA), U8.23 (DDCDAT_B), U29.2 (IO2)
/USBC_Mux/C2_MON2_HPD: J_HDMI_C2_MON2.19 (HPD/HEAC-), R20.1, U8.17 (HPDB), U29.4 (IO3)
/USBC_Mux/MON1_D0_N: J_HDMI_MON1.9 (D0-), U5.2 (IO2), U5.9 (NC), U6.9 (DC2(n))
/USBC_Mux/MON1_D0_P: J_HDMI_MON1.7 (D0+), U5.1 (IO1), U5.10 (NC), U6.8 (DC2(p))
/USBC_Mux/MON1_D1_N: J_HDMI_MON1.6 (D1-), U4.5 (IO4), U4.6 (NC), U6.6 (DC1(n))
/USBC_Mux/MON1_D1_P: J_HDMI_MON1.4 (D1+), U4.4 (IO3), U4.7 (NC), U6.5 (DC1(p))
/USBC_Mux/MON1_D2_N: J_HDMI_MON1.3 (D2-), U4.2 (IO2), U4.9 (NC), U6.3 (DC0(n))
/USBC_Mux/MON1_D2_P: J_HDMI_MON1.1 (D2+), U4.1 (IO1), U4.10 (NC), U6.2 (DC0(p))
/USBC_Mux/MON1_D3_N: J_HDMI_MON1.12 (CK-), U5.5 (IO4), U5.6 (NC), U6.12 (DC3(n))
/USBC_Mux/MON1_D3_P: J_HDMI_MON1.10 (CK+), U5.4 (IO3), U5.7 (NC), U6.11 (DC3(p))
/USBC_Mux/MON1_DDC_CLK: J_HDMI_MON1.15 (SCL), R6.1, U6.18 (DDCCLK_C), U30.1 (IO1)
/USBC_Mux/MON1_DDC_DAT: J_HDMI_MON1.16 (SDA), R14.1, U6.26 (DDCDAT_C), U30.2 (IO2)
/USBC_Mux/MON1_HPD: J_HDMI_MON1.19 (HPD/HEAC-), U6.15 (HPDC), U30.4 (IO3)
/USBC_Mux/MON2_D0_N: J_HDMI_MON2.9 (D0-), U8.5 (DC1(p)), U11.2 (IO2), U11.9 (NC)
/USBC_Mux/MON2_D0_P: J_HDMI_MON2.7 (D0+), U8.6 (DC1(n)), U11.1 (IO1), U11.10 (NC)
/USBC_Mux/MON2_D1_N: J_HDMI_MON2.6 (D1-), U7.5 (IO4), U7.6 (NC), U8.8 (DC2(p))
/USBC_Mux/MON2_D1_P: J_HDMI_MON2.4 (D1+), U7.4 (IO3), U7.7 (NC), U8.9 (DC2(n))
/USBC_Mux/MON2_D2_N: J_HDMI_MON2.3 (D2-), U7.2 (IO2), U7.9 (NC), U8.11 (DC3(p))
/USBC_Mux/MON2_D2_P: J_HDMI_MON2.1 (D2+), U7.1 (IO1), U7.10 (NC), U8.12 (DC3(n))
/USBC_Mux/MON2_D3_N: J_HDMI_MON2.12 (CK-), U8.2 (DC0(p)), U11.5 (IO4), U11.6 (NC)
/USBC_Mux/MON2_D3_P: J_HDMI_MON2.10 (CK+), U8.3 (DC0(n)), U11.4 (IO3), U11.7 (NC)
/USBC_Mux/MON2_DDC_CLK: J_HDMI_MON2.15 (SCL), R15.1, U8.18 (DDCCLK_C), U31.1 (IO1)
/USBC_Mux/MON2_DDC_DAT: J_HDMI_MON2.16 (SDA), R16.1, U8.26 (DDCDAT_C), U31.2 (IO2)
/USBC_Mux/MON2_HPD: J_HDMI_MON2.19 (HPD/HEAC-), U8.15 (HPDC), U31.4 (IO3)
GND: C10.2, C11.2, C12.2, C13.2, C14.2, C15.2, C47.2, C48.2, C49.2, C50.2, J1.A1 (GND), J1.A12 (GND), J1.B1 (GND), J1.B12 (GND), J1.SH (SHIELD), J2.A1 (GND), J2.A12 (GND), J2.B1 (GND), J2.B12 (GND), J2.SH (SHIELD), J_HDMI_C1_MON1.2 (D2S), J_HDMI_C1_MON1.5 (D1S), J_HDMI_C1_MON1.8 (D0S), J_HDMI_C1_MON1.11 (CKS), J_HDMI_C1_MON1.17 (GND), J_HDMI_C1_MON1.SH, J_HDMI_C1_MON2.2 (D2S), J_HDMI_C1_MON2.5 (D1S), J_HDMI_C1_MON2.8 (D0S), J_HDMI_C1_MON2.11 (CKS), J_HDMI_C1_MON2.17 (GND), J_HDMI_C1_MON2.SH, J_HDMI_C2_MON1.2 (D2S), J_HDMI_C2_MON1.5 (D1S), J_HDMI_C2_MON1.8 (D0S), J_HDMI_C2_MON1.11 (CKS), J_HDMI_C2_MON1.17 (GND), J_HDMI_C2_MON1.SH, J_HDMI_C2_MON2.2 (D2S), J_HDMI_C2_MON2.5 (D1S), J_HDMI_C2_MON2.8 (D0S), J_HDMI_C2_MON2.11 (CKS), J_HDMI_C2_MON2.17 (GND), J_HDMI_C2_MON2.SH, J_HDMI_MON1.2 (D2S), J_HDMI_MON1.5 (D1S), J_HDMI_MON1.8 (D0S), J_HDMI_MON1.11 (CKS), J_HDMI_MON1.17 (GND), J_HDMI_MON1.SH, J_HDMI_MON2.2 (D2S), J_HDMI_MON2.5 (D1S), J_HDMI_MON2.8 (D0S), J_HDMI_MON2.11 (CKS), J_HDMI_MON2.17 (GND), J_HDMI_MON2.SH, R7.2, R8.2, R9.2, R10.2, R17.2, R18.2, R19.2, R20.2, R44.2, R46.2, R47.2, R48.2, U4.3 (G), U4.8 (G), U5.3 (G), U5.8 (G), U6.4 (GND), U6.7 (GND), U6.10 (GND), U6.33 (GND), U6.36 (GND), U6.39 (GND), U6.46 (GND), U6.49 (GND), U6.52 (GND), U6.57 (PAD), U7.3 (G), U7.8 (G), U8.4 (GND), U8.7 (GND), U8.10 (GND), U8.33 (GND), U8.36 (GND), U8.39 (GND), U8.46 (GND), U8.49 (GND), U8.52 (GND), U8.57 (PAD), U11.3 (G), U11.8 (G), U12.3 (G), U12.8 (G), U13.3 (G), U13.8 (G), U14.3 (G), U14.8 (G), U15.3 (G), U15.8 (G), U16.3 (G), U16.8 (G), U17.3 (G), U17.8 (G), U18.3 (G), U18.8 (G), U19.3 (G), U19.8 (G), U24.3 (G), U24.8 (G), U25.3 (G), U25.8 (G), U26.3 (G), U26.8 (G), U27.3 (G), U27.8 (G), U28.3 (G), U28.8 (G), U29.3 (G), U29.8 (G), U30.3 (G), U30.8 (G), U31.3 (G), U31.8 (G), U32.2 (GND), U33.2 (GND); also elsewhere on the board
HDMI_ILIM1: R47.1, U32.5 (ILIM)
HDMI_ILIM2: R48.1, U33.5 (ILIM)
HDMI_MODE_1: R43.2, R44.1, U6.1 (AUX_SEL)
HDMI_MODE_2: R45.2, R46.1, U8.1 (AUX_SEL)
HDMI_MON1_5V: C49.1, J_HDMI_MON1.18 (+5V), R6.2, R14.2, U32.6 (OUT)
HDMI_MON2_5V: C50.1, J_HDMI_MON2.18 (+5V), R15.2, R16.2, U33.6 (OUT)
HOST1_CC1: J1.A5 (CC1), R9.1, U24.4 (IO3), U24.7 (NC)
HOST1_CC2: J1.B5 (CC2), R10.1, U24.5 (IO4)
HOST1_VBUS: J1.A4 (VBUS), J1.A9 (VBUS), J1.B4 (VBUS), J1.B9 (VBUS); also elsewhere on the board
HOST2_CC1: J2.A5 (CC1), R7.1, U25.4 (IO3), U25.7 (NC)
HOST2_CC2: J2.B5 (CC2), R8.1, U25.5 (IO4)
HOST2_VBUS: J2.A4 (VBUS), J2.A9 (VBUS), J2.B4 (VBUS), J2.B9 (VBUS); also elsewhere on the board
HOST_SELECT: U6.56 (Dx_SEL), U8.56 (Dx_SEL); also elsewhere on the board
MUX_RESET: U6.43 (OE), U8.43 (OE); also elsewhere on the board
USB_HOST1_N: J1.A7 (D-), J1.B7 (D-), U24.2 (IO2), U24.9 (NC); also elsewhere on the board
USB_HOST1_P: J1.A6 (D+), J1.B6 (D+), U24.1 (IO1), U24.10 (NC); also elsewhere on the board
USB_HOST2_N: J2.A7 (D-), J2.B7 (D-), U25.2 (IO2), U25.9 (NC); also elsewhere on the board
USB_HOST2_P: J2.A6 (D+), J2.B6 (D+), U25.1 (IO1), U25.10 (NC); also elsewhere on the board

Notes on the sheet:
HDMI mode: AUX_SEL must be VDD/2. 10k/10k dividers; never leave AUX_SEL floating (TI datasheet section 7.5).
External-port ESD: 5.5V-rated arrays on USB D+/D-/CC and HDMI DDC/HPD. TPD4E02B04 arrays remain on the eight TMDS conductors of each HDMI connector.
HDMI input pin 18 rails are isolated from board +5V and from each other.

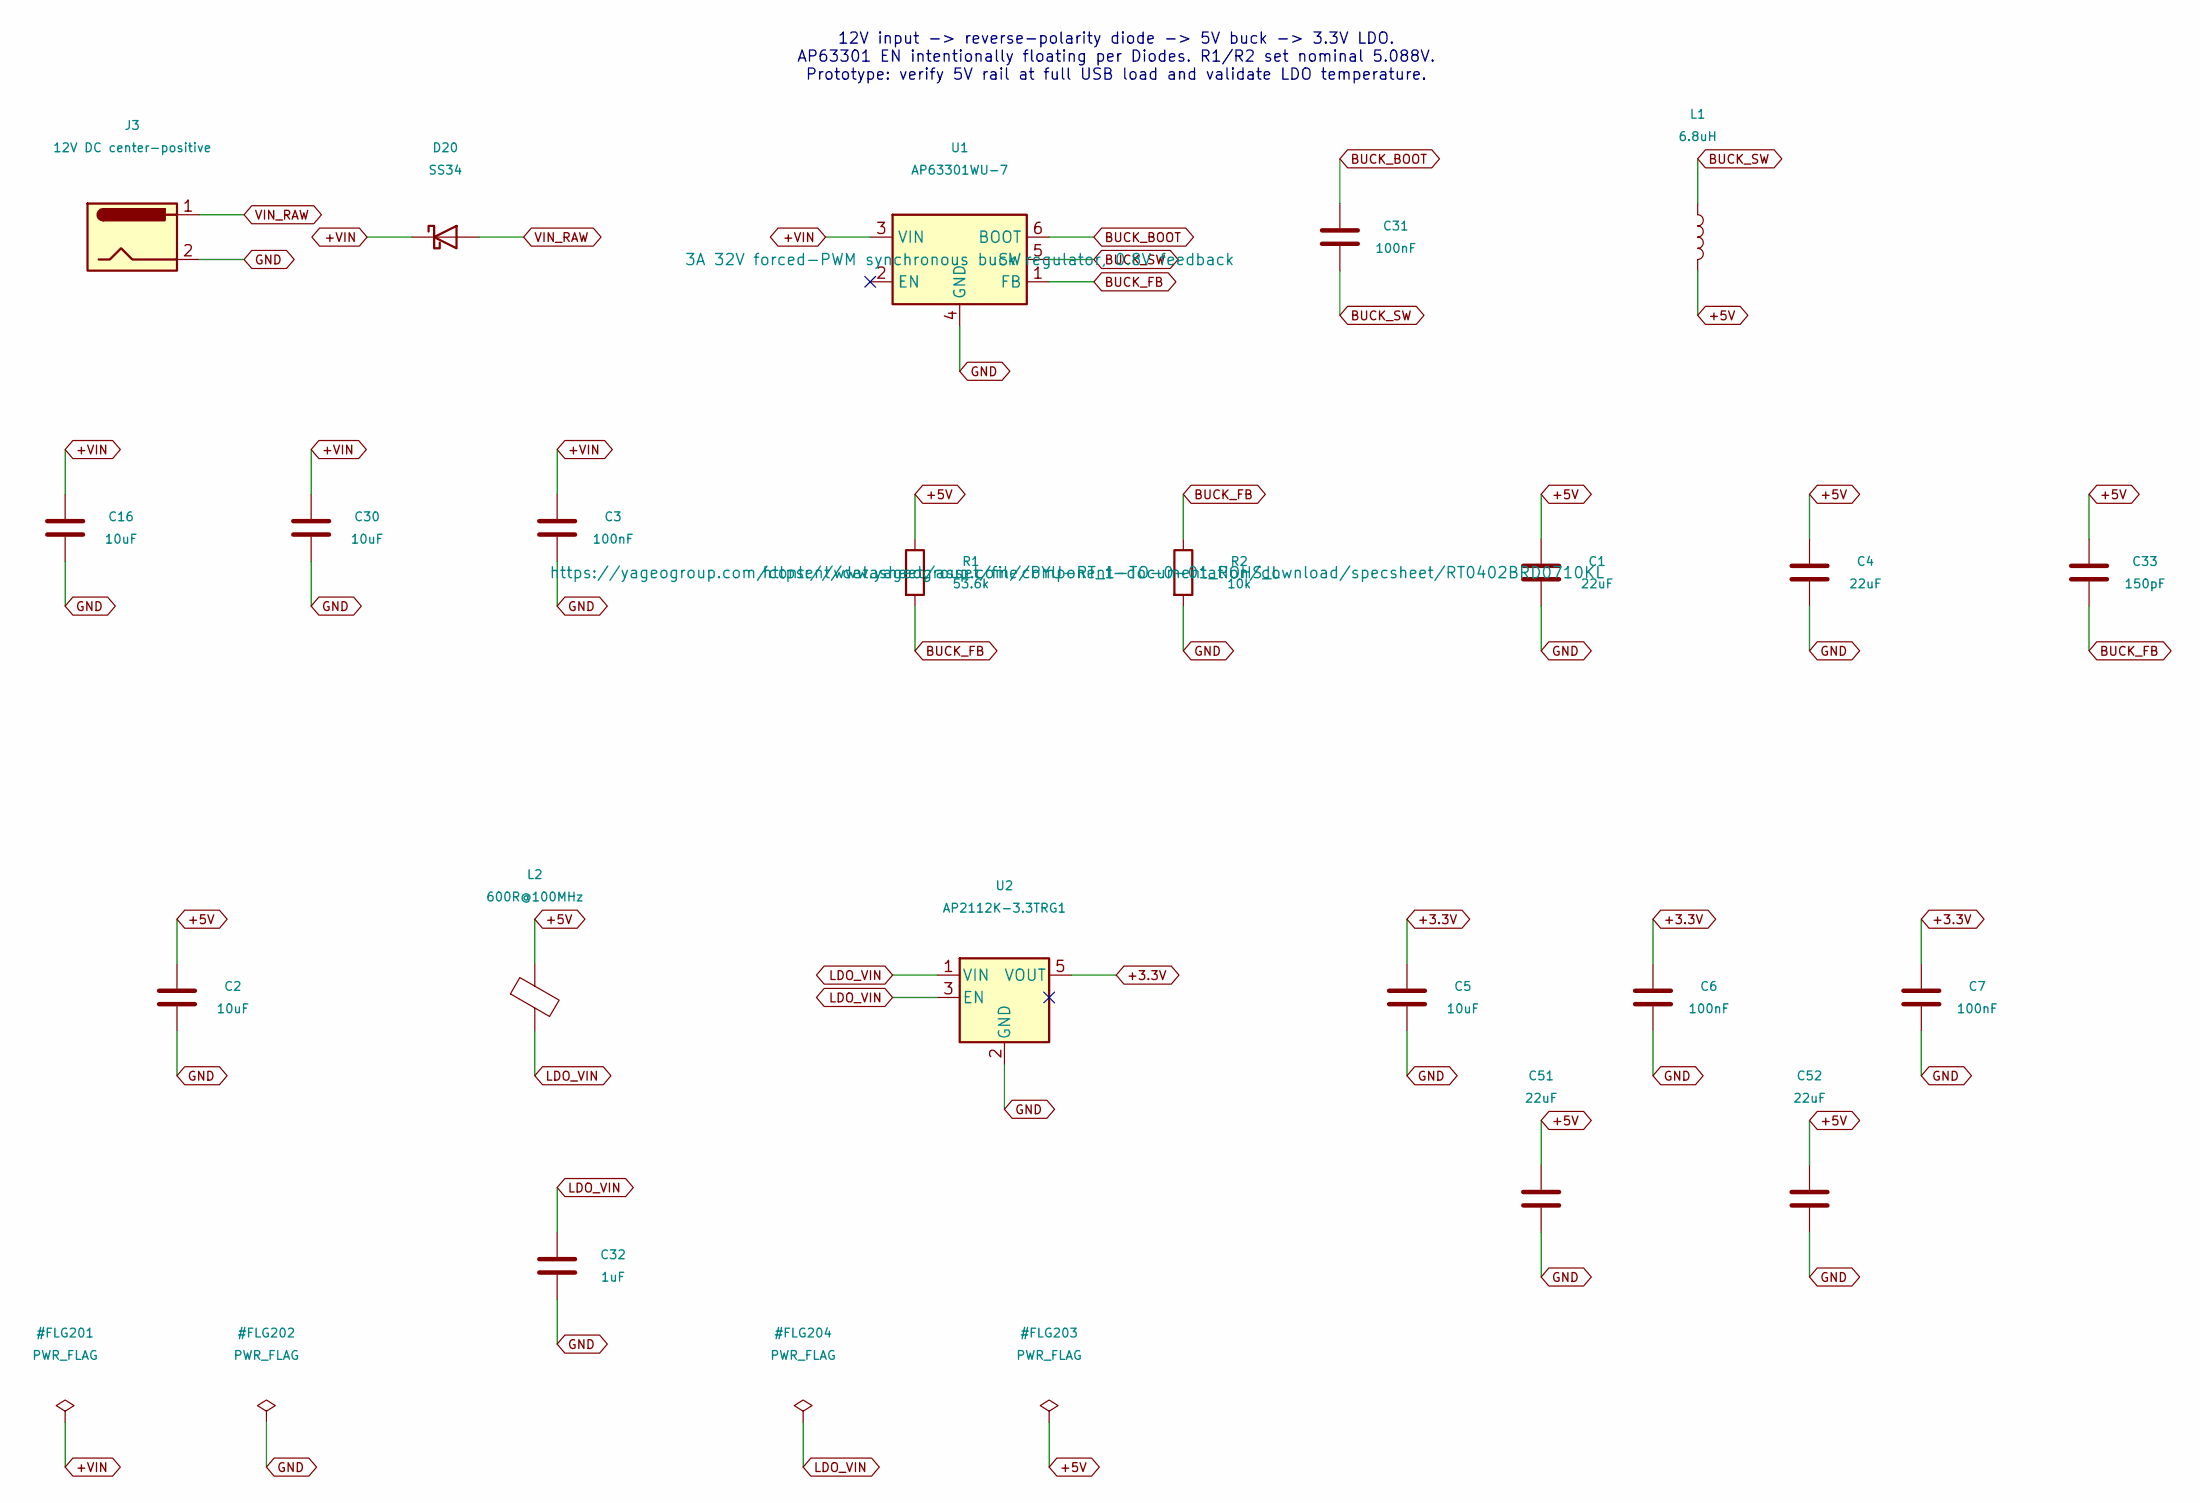
[picture p8: schematic sheet_pdn.kicad_sch, Two-computer HDMI and USB switch]

Parts:
C1, C4, C51, C52: 22uF; C_1206_3216Metric; Voltage 25V; MPN CL31A226KAHNNNE; LCSC Part C12891
C2, C5: 10uF; C_0805_2012Metric; Voltage 16V; MPN CL21B106KOQNNNE; LCSC Part C95841
C3, C6, C7, C31: 100nF; C_0402_1005Metric; Voltage 50V; MPN CC0402KRX7R9BB104; LCSC Part C131394
C16, C30: 10uF; C_1206_3216Metric; Voltage 50V; MPN CL31B106KBHNNNE; LCSC Part C89632
C32: 1uF; C_0603_1608Metric; Voltage 16V; MPN CL10B105KO8NNNC; LCSC Part C59782
C33: 150pF; C_0402_1005Metric; Voltage 50V; Tolerance 5%; MPN CL05C151JB5NNNC; LCSC Part C86286
D20: SS34; D_SMA; Rating 40V 3A; reverse-polarity isolation; MPN SS34; LCSC Part C8678
J3: 12V DC center-positive; BarrelJack_Wuerth_694106106102_2.0x5.5mm; MPN 694106106102; LCSC Part C7420206
L1: 6.8uH; Bourns_SRP7050TA; MPN SRP7050TA-6R8M; LCSC Part C2046414
L2: 600R@100MHz; L_0805_2012Metric; MPN BLM21PG601SN1D; LCSC Part C41556732
R1: 53.6k; R_0402_1005Metric; Tolerance 0.1%; MPN RT0402BRD0753K6L; LCSC Part C852835
R2: 10k; R_0402_1005Metric; Tolerance 0.1%; MPN RT0402BRD0710KL; LCSC Part C190095
U1: AP63301WU-7; SOT-23-6; MPN AP63301WU-7; LCSC Part C2158003
U2: AP2112K-3.3TRG1; SOT-23-5; MPN AP2112K-3.3TRG1; LCSC Part C51118

Connections:
+3.3V: C5.1, C6.1, C7.1, U2.5 (VOUT); also elsewhere on the board
+5V: C1.1, C2.1, C4.1, C33.1, C51.1, C52.1, L1.2, L2.1, R1.1; also elsewhere on the board
+VIN: C3.1, C16.1, C30.1, D20.1 (K), U1.3 (VIN)
BUCK_BOOT: C31.1, U1.6 (BST)
BUCK_FB: C33.2, R1.2, R2.1, U1.1 (FB)
BUCK_SW: C31.2, L1.1, U1.5 (SW)
GND: C1.2, C2.2, C3.2, C4.2, C5.2, C6.2, C7.2, C16.2, C30.2, C32.2, C51.2, C52.2, J3.2, R2.2, U1.4 (GND), U2.2 (GND); also elsewhere on the board
LDO_VIN: C32.1, L2.2, U2.1 (VIN), U2.3 (EN)
VIN_RAW: D20.2 (A), J3.1

Notes on the sheet:
12V input -> reverse-polarity diode -> 5V buck -> 3.3V LDO. AP63301 EN intentionally floating per Diodes. R1/R2 set nominal 5.088V. Prototype: verify 5V rail at full USB load and validate LDO temperature.

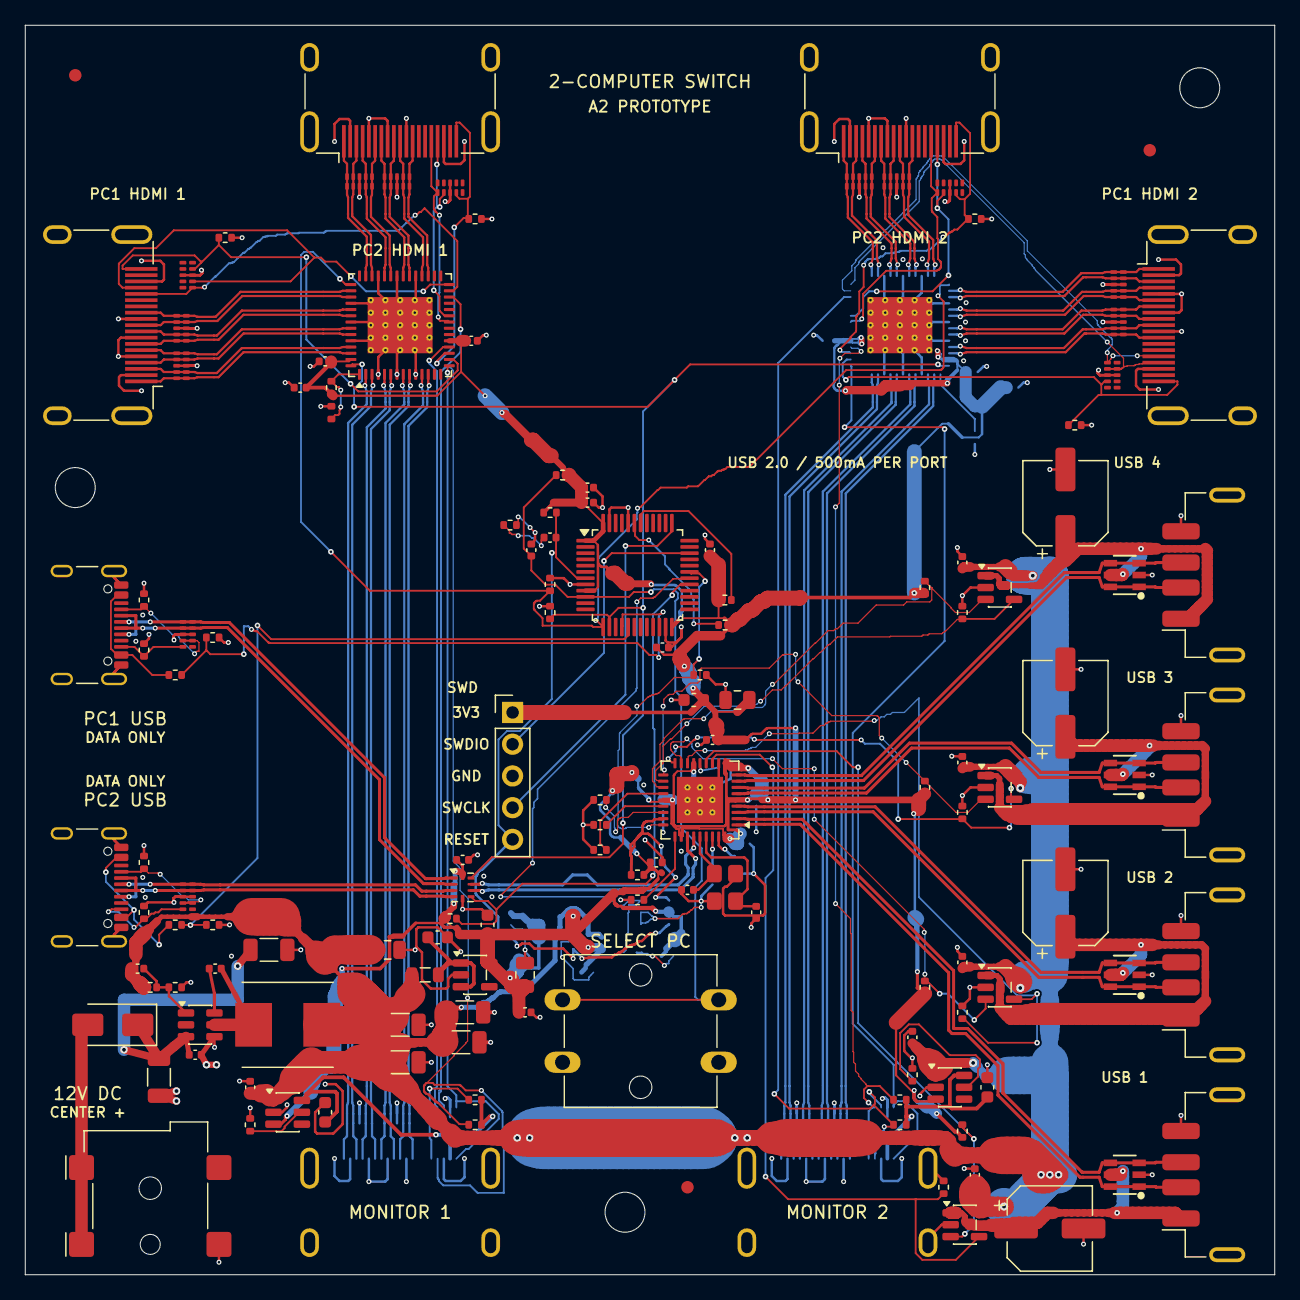
[picture p9: board KVM_Switch.kicad_pcb from above]

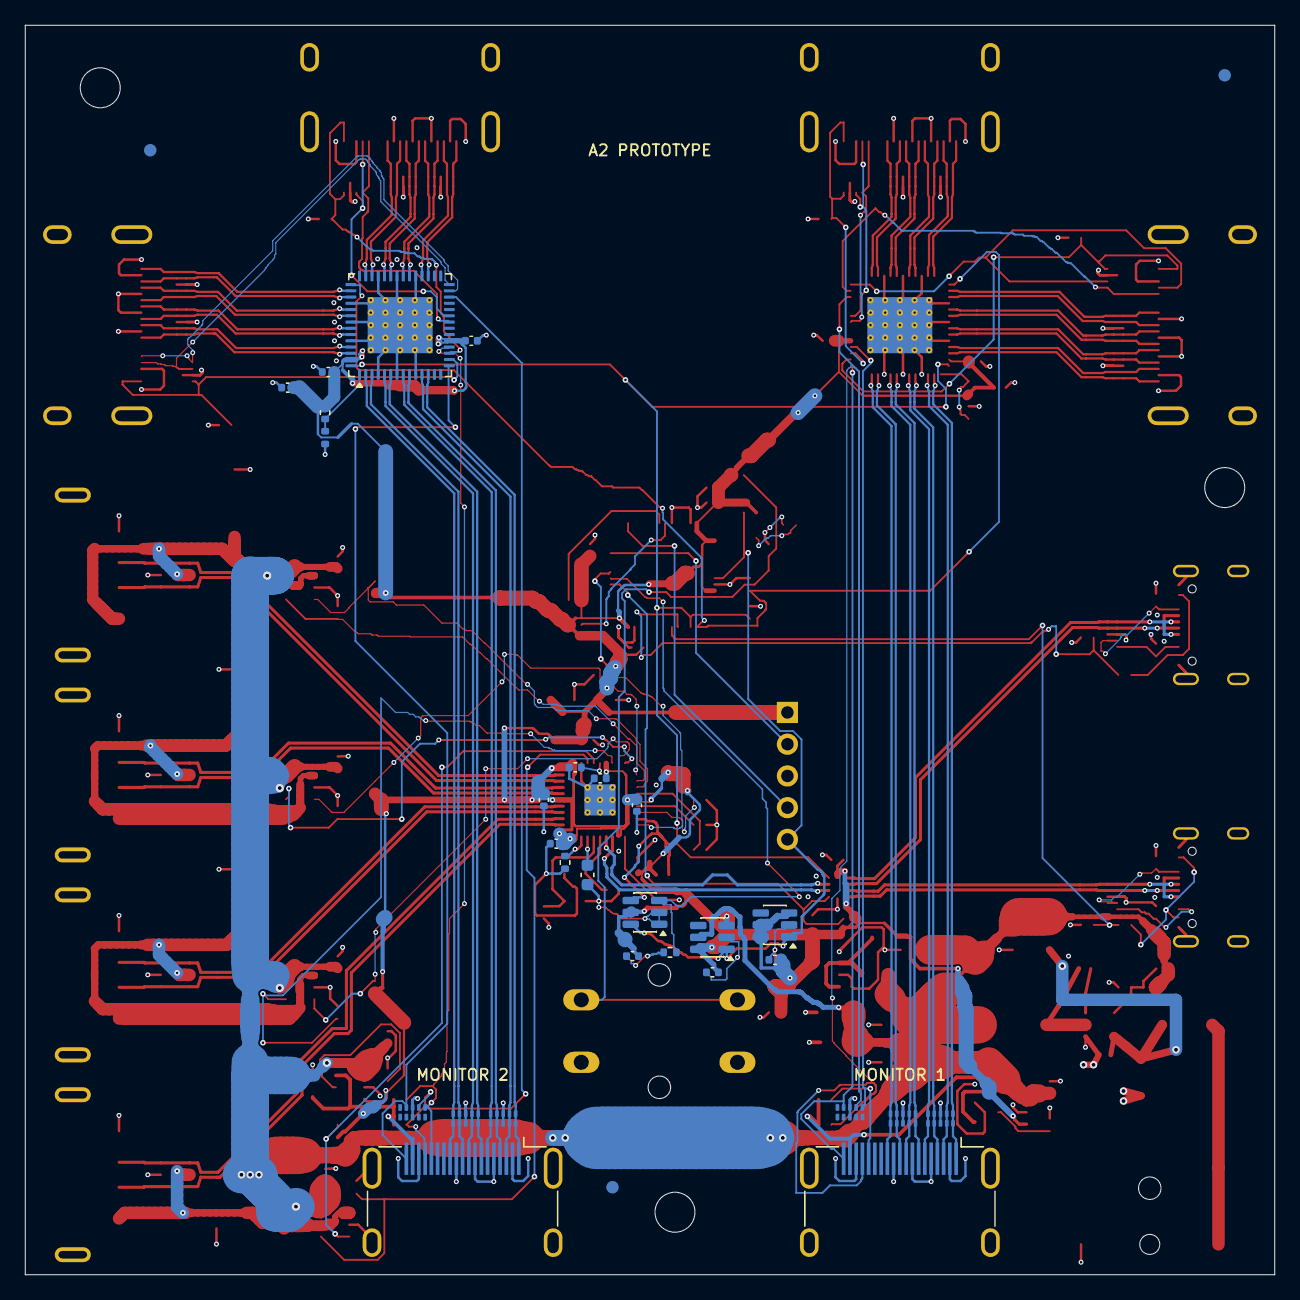
[picture p10: board KVM_Switch.kicad_pcb from below]

Board: 4 copper layers, 100.0 x 100.0 mm, 170 parts (31 on the bottom side), 137 nets.

Other parts of the board:
FID1, FID2, FID3, FID4, FID5, FID6: Fiducial_1mm_Mask2mm
H1, H2, H3: M3 mounting; MountingHole_3.2mm_M3
