Rithvik-Vadlamani/kvm-switch/(commit log)

2026-09-02 changing some of the schematic
    [KVM_Switch.kicad_pcb, KVM_Switch.kicad_sch, sheet_hub.kicad_sch .kicad_sch, sheet_pdn.kicad_sch, sheet_stm32.kicad_sch, sheet_usbc.kicad_sch]
2026-10-14 Publish A2 hardware, firmware, and verification package
    [KVM_Switch.kicad_pcb, KVM_Switch.kicad_sch, PCB-DRC.json, sheet_hub.kicad_sch .kicad_sch, sheet_pdn.kicad_sch, sheet_stm32.kicad_sch, sheet_usbc.kicad_sch]
